OAKHEN1412/reaction-wheel-balance/HANDOFF.md

# Handoff — Reaction Wheel Balance

## 2026-09-19 ? Voltage/torque controller implemented

This supersedes the older speed-command diagnosis below: light-wheel steps
156/291/425 rpm at duty .29/.49/.68, t63 .155/.175/.215 s; adding rim nuts
increases tau to .45?.59 s with almost unchanged final rpm. Driver is voltage
mode, not a soft-start speed servo. Sim and firmware now default to signed
back-EMF compensation `(omega_est + .18*a)/omega_fs`; old mode stays selectable.
Measured electrical/IMU/FG constants preserved. DIR uses one zero-duty interval
then reverses even while spinning; estimator follows applied duty. CSV unchanged
but cmd_rpm now represents voltage-equivalent speed. No upload or COM3 access.

Keep Kp=1137.4, Kd=144.3, Kw=1, Ki=.0387; CONTROL_MODE_VOLTAGE=true,
MOTOR_TAU_S=.18 (light wheel), ACTIVE_DECEL_BRAKE=false. Saved EEPROM gains
still override config defaults. Six-case nominal recovery: 20/20 except
(.25 s, coast=.3) = 18/20; fixed-gain wheel-inertia sweep worst = 17/20,
one saturated run. Soft gains/higher Kd did not help.
Validation: 15/15 Python tests pass; Mega compile passes (24078 B flash,
1613 B SRAM). Extended firmware self-test compiled, not executed on board. See sim/README.md and
sim/voltage_results.json for protocol, limits and complete results. Need wheel
mass/inertia, low-duty behavior, FG sign accuracy and reverse/braking torque
measurements before treating these model results as hardware validation.

อัปเดตล่าสุด: 2026-09-19 · repo: `OAKHEN1412/reaction-wheel-balance`

## เป้าหมายโปรเจค
โครงตัว U ทรงตัวบนขอบฐานด้วยล้อเหวี่ยง 20 cm (reaction wheel) บนแกน X — **Arduino Mega 2560** อ่าน MPU-6050 แล้วสั่ง BLDC-3640 ขอบเขตในโครงงาน: เอียงไม่เกิน 5° บนพื้นราบ
ภาพรวม สเปก และงบประมาณอยู่ใน `project-brief.md` (สรุปจากสไลด์ PDF และ xlsx ของผู้ใช้ — สไลด์เดิมระบุ ESP32-C3 แต่โปรเจคเปลี่ยนเป็น Mega ถาวรแล้ว ดูหมายเหตุในไฟล์นั้น) และ `README.md`

## ทำเสร็จแล้ว (อ่านรายละเอียดจากไฟล์ ไม่ต้องทำซ้ำ)
| ส่วน | ไฟล์ | สถานะ |
|---|---|---|
| วงจร | `hardware/wiring.md`, `hardware/schematic.svg/.png` | รีวิวแล้ว ขาตรงตามสเปก |
| เฟิร์มแวร์ | `firmware/reaction_wheel_balance/`, `firmware/imu_test/`, `firmware/motor_test/`, `firmware/README.md` | compile ผ่านทุก sketch (รวม `sign_test`) · รีวิวและแก้ไปแล้ว 1 รอบ (8 จุด) |
| Simulation | `sim/` (`design_gains.py --set … --quick`, `hardware_requirements.py`, `README.md`) | unittest ผ่าน 8/8 |
| หน้าเว็บภาพรวม | `project-overview.html` + `assets/` (เผยแพร่เป็น artifact ส่วนตัว — ลิงก์อยู่กับเจ้าของโปรเจค) | v2 มีรูปโมดูลจริงและภาพ CAD แล้ว |

คำสั่ง compile: `arduino-cli compile --fqbn arduino:avr:mega firmware/<sketch>` (avr core ติดตั้งอยู่แล้ว) · upload ที่ `COM3` · Python ใช้ `py -X utf8`

## ข้อสรุปสำคัญ (ไม่ชัดเจนถ้าอ่านจากโค้ดอย่างเดียว)
- **กฎควบคุม:** ใช้ state feedback แล้วคำนวณเป็นความเร่งล้อ `a = Kp·θ + Kd·θ̇ + Kw·ω + Ki·∫θ` จากนั้นสะสมเป็น ω_cmd **ห้ามแปลงมุมเป็น PWM ตรง ๆ** เพราะแรงบิดปฏิกิริยาเป็นสัดส่วนกับความเร่งของล้อ
- **เกนทุกตัวเครื่องหมายบวกเหมือนกัน** ตาม LQR · Kp มีค่าต่ำสุดประมาณ m·g·l / I_w จึงห้ามจูนแบบเริ่มจาก Kp = 0 · เกนตั้งต้นใน `config.h` คือ Kp 1137, Kd 144.3, Kw 1.0, Ki 0.0387 ตรวจซ้ำที่อัตราทดจริง 6 แล้ว ได้ค่าเท่าเดิม (tau_m 0.06 s ยังเป็นค่าประมาณ)
- **Simulation:** ถ้าออกแบบเกนให้ตรงกับพารามิเตอร์แต่ละชุด จะฟื้นจาก 5° ได้ 19/20 รอบ แต่ต้องมีอัตราทด ≥ 3, แรงบิดล้อ ≥ 1.5 เท่าของแรงโน้มถ่วง และ tau_m ≤ 0.08 s · ฟื้นจาก 10° ไม่ได้ · **โหมดลุกเองจากท่านอน (jump-up) ทำไม่ได้** กับมอเตอร์นี้ (`ENABLE_JUMP_UP=false`)
- ยอด Monte Carlo ต่ำ ๆ ที่ worker รายงานรอบแรกเกิดจากใช้เกนชุดเดียวกับพารามิเตอร์ทุกช่วง แก้วิธีวัดแล้ว ดู `sim/README.md` §3.5–3.7
- รูป ESP32 และแบตในสไลด์เดิมไม่ตรงรุ่นที่ใช้จริง · รูปใน `assets/modules/` มาจากลิงก์ร้านใน xlsx

## ทดสอบฮาร์ดแวร์จริง 2026-09-19
- **MPU-6050 (GY-521) ตัวที่มีเสีย:** ตอบ WHO_AM_I=0x68, ACK ทุก byte (ยืนยันด้วย bit-bang I2C) แต่เขียน register ไม่ติด ค้าง sleep (PWR_MGMT_1=0x40) ค่า accel/gyro เป็น 0 — ต้องซื้อใหม่ · มี `tools/imu_viewer.html` (Codex สร้าง, Web Serial + 3D + Auto-suggest แกน/เครื่องหมาย) รอใช้กับตัวใหม่
- **มอเตอร์ BLDC-3640 วัดครบแล้ว** (ใส่ใน `config.h` + `wiring.md` แล้ว): สีสายจริง แดง +12V / ดำ GND / น้ำเงิน PWM **กลับขั้ว** (เริ่มหมุน ~10%) / เหลือง FG (~70 พัลส์ต่อรอบล้อ, ส่งเฉพาะตอนไดร์เวอร์ขับ) / ขาว DIR (LOW = CW) / เขียว BRAKE (LOW = เบรก, ผลน้อยกว่า duty 0 นิดเดียว)
- **เปลี่ยนคอนโทรลเลอร์เป็น Arduino Mega 2560 ถาวรแล้ว** — ขาว (DIR) และเขียว (BRAKE) มี pull-up ในไดร์เวอร์แรง (~1kΩ ไป 5V) ESP32 (3.3V) ผ่าน R ดึงลงไม่ได้ ต้องใช้ NPN ช่วย ส่วน Mega เป็น 5V logic ต่อตรงได้เลย **ไม่ต้องใช้ NPN อีกต่อไป** เฟิร์มแวร์พอร์ตเสร็จแล้ว เวอร์ชัน ESP32 เดิมย้ายไปเก็บที่ `firmware/legacy_esp32/`
- **ความปลอดภัย:** PWM กลับขั้ว → ถ้าขา PWM ลอย/LOW มอเตอร์วิ่งเต็มสปีด · **ปิดไฟ 12V ทุกครั้งก่อนแฟลช/รีเซ็ตบอร์ด** (Mega ก็ยังมีความเสี่ยงนี้ตอน reset/upload เหมือนกัน) · แนะนำใส่ pull-up 10k จาก D11 ไป 5V เป็น hardware safety net เพิ่มเติม
- `motor_test.ino` (Mega) รองรับคำสั่ง `duty`, `dir`, `brake`, `stop`, `count`, `resetcount`, `status`, `help`

## ยังค้าง / ขั้นต่อไป
0. **อัตราทดวัดแล้ว = 6** (2026-09-19 นับด้วยมือ: ล้อ 1 รอบ = มอเตอร์ 6 รอบ) ใส่ใน `config.h` และ `sim/params.py` แล้ว · รัน sim ใหม่ได้เกนเท่าเดิม ฟื้นจาก 5° ได้ 19/20 รอบ ไม่อิ่มตัว ล้อหมุนสูงสุด 157 จากขีดจำกัด 667 rpm แรงบิดล้อ 0.46 N·m เท่ากับ ~4 เท่าของแรงโน้มถ่วงที่ 5° · FG น่าจะเป็น 12 พัลส์ต่อรอบมอเตอร์ (72 ต่อรอบล้อ) ไม่ใช่ 70 ถ้าจะให้แม่นให้นับซ้ำ
1. **MPU-6050 ตัวใหม่ใช้งานได้แล้ว (2026-09-19)**: WHO_AM_I=0x68 ตอนวางนิ่ง az≈1.05g และ gyro bias ≈ (-1.1, 0.5, 1.7) dps · **ยืนยันแกนแล้ว:** accel ใช้ atan2(ay,az), gyro ใช้ X และเครื่องหมาย +1 ทั้งคู่ (Δθ +9.4°, corr 0.74) ใส่ใน `config.h` แล้ว ถ้าย้ายตำแหน่ง IMU ต้องวัดใหม่
1b. **ทิศควบคุมยืนยันแล้ว** (2026-09-19 ด้วย `firmware/sign_test/`): ล้อเร่งไป +ω แล้วโครงเอียงไป θ ลบ -10.3° · ล้อเร่งไป -ω แล้วโครงเอียงไป θ บวก +7.0° → `DEFAULT_CONTROL_SIGN = +1` ถูกต้อง · ทิศทางจริง: **เอียงซ้าย = θ ลบ** · IMU ตอนตั้งตรงอ่านได้ประมาณ -2 ถึง -3° ใช้คำสั่ง `zero` ในเฟิร์มแวร์หลัก
1c. **ทดสอบทรงตัวครั้งแรก (2026-09-19) ไม่สำเร็จ:** zero offset = -0.28° (บันทึกลง EEPROM แล้ว) · ทิศที่ controller ดันกลับถูกต้อง แต่โครงแกว่งแรงขึ้นทุกรอบ (+2.8 → -7.8 → +10.8 → -16.9°, คาบ ~0.85 s) แล้วล้มใน ~1.5 s เพราะล้อหมุนตามคำสั่งได้แค่ประมาณ 1/5 · `firmware/step_test/` วัดซ้ำ 2 รอบได้ผลเหมือนกัน: t63 = **0.45–0.59 s** (sim สมมติไว้ 0.06 s), ที่ duty เต็มล้อหมุนได้ประมาณ 585 rpm, ความเร่งสูงสุดของล้อประมาณ 50 rad/s² ≈ แรงบิด 0.125 N·m (ถ้า I_w = 0.00245) ซึ่งแค่พอสู้แรงโน้มถ่วงที่ 5° (0.108 N·m) sim เคยสมมติไว้ 0.46 · sim ที่ tau_m 0.15–0.45 ได้ 0/20 · ขั้วเวลาไม่เสถียรของโครงประมาณ 0.13 s เร็วกว่ามอเตอร์ประมาณ 4 เท่า → **ปัญหาอยู่ที่ฮาร์ดแวร์ ไม่ใช่การจูน** ดูทางเลือกในข้อ 2 · FG ส่งพัลส์เฉพาะตอนขับ จึงวัด coast ไม่ได้
2. **ขั้นต่อไป: เลือกทางแก้ actuator** (ก) หาว่าไดรเวอร์มี soft-start/accel ramp ไหม (ข) เพิ่มอัตราทดเป็นประมาณ 10–12 เพราะความเร็วล้อยังเหลือเยอะ (ค) ลดแรงโน้มถ่วง m·l: ย้ายแบตหรือ Mega ลงต่ำ (ง) ถ้ามอเตอร์รับได้ ลองใช้ไฟ 24V · เดิม: **ทดสอบทรงตัวครบระบบครั้งแรก** แกน IMU, อัตราทด, `MOTOR_MIN_DUTY_FRACTION` และทิศควบคุมวัดครบแล้ว · แฟลช `reaction_wheel_balance` ตอนปิด 12V → ตั้งตรงแล้วใช้คำสั่ง `zero` → `start` โดยมีมือกันล้มไว้
3. หลังวัดมวล COM I_w และ tau_m จริง (รวมมวล/COM ที่เปลี่ยนไปจาก Mega ที่หนักกว่า ESP32-C3 Super Mini มาก — ~37g เทียบ ~2g, ขนาด ~101.5×53.3mm เทียบ ~22×18mm ต้องคิดในตำแหน่งจริงบนโครง) → รัน `sim/design_gains.py --set … --quick` → อัปเดตเกน
4. สไลด์ยังว่างสองหน้า: "ทบทวนงานวิจัยที่เกี่ยวข้อง" และ "สรุปและข้อเสนอแนะ" · ตัวเลขงบในสองชีตของ xlsx ไม่ตรงกัน

## ข้อตกลงการทำงานกับผู้ใช้
- สื่อสารภาษาไทย · ผู้ใช้สั่งงานแบบหัวหน้าคุมลูกน้อง ผ่าน skill `/engineer`: Opus วางแผนและรีวิว ส่วน `worker-general` (Sonnet) ลงมือทำ
- งานยาวให้แจ้งผ่าน PushNotification เมื่อเสร็จ
- ถ้าแก้หน้าเว็บให้ republish ที่ URL เดิม (ใช้ `url` ถ้าอยู่ต่าง session) อย่าสร้าง artifact ใหม่

## Suggested skills
- `engineer` — เมื่อต้องแตกงานให้ worker ทำ (แก้วงจรเพิ่มไดโอด, bring-up tooling)
- `artifact-design` — ก่อนแก้ `project-overview.html` แล้ว republish
- `diagnose` / `debug-mantra` — ตอนทดสอบกับเครื่องจริงแล้วเจอบั๊ก (บูตไม่ขึ้น, ทรงตัวไม่ได้, IMU อ่านไม่ได้)
- `tdd` — ถ้าเพิ่ม logic ใหม่ใน header pure-logic ของเฟิร์มแวร์ หรือใน `sim/`
- `tailsync` — ถ้าต้องย้ายไฟล์ใหญ่ เช่นไฟล์ CAD หรือ log telemetry ไปเครื่อง hub

## ทดสอบทรงตัวรอบ 2 (voltage mode, 2026-09-19)
- ทรงตัวได้ประมาณ 1–7 วินาทีต่อครั้ง (20 ครั้ง) ดีกว่ารอบแรก แต่ยังล้มทุกครั้ง · log: scratchpad `balance_attempt2.log`
- **สาเหตุหลัก: FG มีพัลส์หลอก** (ห่างกันประมาณ 25–35 µs ช่วงที่กลับทิศ) ทำให้อ่านความเร็วล้อได้ 30,000–42,000 rpm → ในโหมด voltage ทำให้ duty ชน 100% ไปทิศผิดนานประมาณ 300 ms (เกิด 588 จาก 7204 sample)
  - แก้แล้วใน `fg_tach.cpp`: ทิ้งพัลส์ที่ห่างกันน้อยกว่า `FG_MIN_PERIOD_US` (700 µs) และให้ค่าความเร็วลดลงเองเมื่อไม่มีพัลส์ใหม่ · ~~ใส่ pull-up 4.7k~~ **ห้ามใส่** (ดูหัวข้อ 2026-09-20: ใส่แล้ว FG แย่ลง)
- ปัญหารอง: 20–40% ของเวลา duty อยู่ใต้ 0.10 ซึ่งเป็นช่วงที่มอเตอร์ไม่ออกแรง ถ้าแก้ FG แล้วยังส่ายไปมาช้า ๆ ให้เพิ่มการชดเชย deadzone ในโหมด voltage

## 🎉 ทรงตัวได้สำเร็จครั้งแรก (2026-09-19, รอบ 3 + จูน Kd)
- ใช้โหมด voltage + ตัวกรอง FG · Kd 144.3 (ค่าจาก LQR) → ทรงได้ 1.5–8 วินาที · Kd 220 → ดีขึ้นมาก · **Kd 300 → ทรงได้ต่อเนื่องมากกว่า 2 นาทีโดยไม่ล้ม**
- 10 วินาทีสุดท้าย: θ เฉลี่ย -0.33°, SD 1.7°, อยู่ในช่วง -3.7 ถึง +3.1° · ส่ายด้วยคาบ ~0.47 s · ล้อหมุนเฉลี่ย +137 rpm (ช่วง 40–223) · duty สูงสุด 0.47 · ไม่พบค่าหลอกจาก FG
- บันทึก Kd 300 ลง EEPROM แล้ว และตั้งเป็น `DEFAULT_KD` ใน `config.h` แล้ว (Kp 1137.4, Kw 1.0, Ki 0.0387 เท่าเดิม)
- ขั้นต่อไป: ลดการส่าย (ลอง Kd 350–400 หรือปรับ Kp), ล้อค้างอยู่ฝั่งบวกประมาณ 137 rpm (ลองเพิ่ม Kw เพื่อดึงความเร็วล้อกลับศูนย์), ทดสอบรับแรงผลัก

### จูนลดการส่าย (Kd, เปลี่ยนค่าระหว่างที่ทรงตัวอยู่)
| Kd | SD ของ θ | ช่วงของ θ | คาบการส่าย |
|---|---|---|---|
| 300 | 1.59° | -4.3 ถึง +3.7° | 0.46 s |
| 350 | 0.71° | -2.4 ถึง +1.9° | 0.35 s |
| 400 | 0.49° | -2.5 ถึง +2.1° | 0.28 s |
| **500** | **0.34°** | **-1.4 ถึง +0.8°** | 0.20 s |
- **ใช้ Kd 500** บันทึกลง EEPROM และตั้งเป็น `DEFAULT_KD` แล้ว · duty กระตุกเพิ่มขึ้นประมาณ 20% แต่ยังไม่มีอาการสั่นหรือเสียงหึ่ง · ถ้าเพิ่ม Kd ต่อ ได้ประโยชน์น้อยลงเรื่อย ๆ และเสี่ยงสัญญาณรบกวน
- ความเร็วล้อค้างเฉลี่ยประมาณ -91 rpm (ไม่กลับศูนย์) → ถ้าจะแก้ ลองเพิ่ม Kw

## Jump-up (ลุกขึ้นเองจาก ±16°) + หน้าเว็บควบคุม (2026-09-19, Codex)
- **sim** (`sim/jumpup.py`, ผลทั้งหมดอยู่ที่ `sim/out/jumpup/` + README): ใช้โมเดล voltage-mode + reverse-plugging รัน 2,970 กรณี → ทำได้ในทางทฤษฎีที่ความเฉื่อยล้อ ≥0.75× ของค่าประมาณ แม้ในกรณีแย่ (plug ได้แรงครึ่งเดียว + dead time 20–50 ms) · ที่ 0.5× ต้อง ≥250 rpm และถ้า pessimistic จะไม่สำเร็จเลย · ยังไม่ได้ทดสอบกับเครื่องจริง
- **เฟิร์มแวร์:** `jump_controller.h` + คำสั่ง `jump [rpm] [kick_ms]` / `jumpcfg` · ต้องสั่งเองเท่านั้น, โครงต้องวางพักนิ่ง 10–22° นาน 500 ms, ต้องเห็นพัลส์ FG จริง, จำกัดความเร็วล้อ ≤550 rpm, kick ≤500 ms, ยกเลิกเมื่อเอียงเกิน 25° หรือเกิน 2 s · ค่าเริ่มต้นแบบปลอดภัย `jump 100 20` (ยกขึ้นแค่ประมาณ 1°) · ค่าที่คาดว่าจะใช้ได้ `jump 200 350`
- **หน้าเว็บ** `tools/imu_viewer.html` แท็บ Balance control: ปุ่ม Start/Stop(Esc)/Jump/Zero, แก้เกน, กราฟ real-time, สถิติ, บันทึก CSV, serial console
- ขั้นต่อไป: แฟลช (ปิด 12V) → ทดสอบ jump แบบค่อย ๆ เพิ่ม: 100/20 → 100/100 → 150/200 → 200/350 โดยมีมือกันอีกฝั่งไว้

## 🎉 ลุกขึ้นเองสำเร็จ (2026-09-20)
- **`jump 500 350` ลุกจาก -15.6° ขึ้นมาตั้งตรง แล้วทรงตัวต่อได้เอง** (ยังทรงตัวอยู่หลังจากนั้นอีกกว่า 10 วินาที) · log: scratchpad `jump_success.log`
  - หมุนล้อที่ duty 1.0 จนถึง 480 rpm (ใช้ประมาณ 380 ms) → กลับทิศเต็มกำลัง → โครงยกขึ้นเร็วสุด 76 °/s → ส่งต่อเข้าโหมดทรงตัวที่ -9.5° ภายใน ~190 ms → เลยไปอีกฝั่งสูงสุด +4.4° → กลับมานิ่งที่ประมาณ 0°
- เส้นทางการทดสอบ: 100/20 ยกขึ้น 1.7° · 100/100 ~-3.5° แต่เบรกตอน abort ดึงกลับ · 100/200 และ 200/350 ส่งต่อได้ที่ -9.5° แต่ตอนนั้นโครงกำลังตกกลับ · 350/350 ขึ้นถึง -3° แต่ความเร็วล้อไม่พอ · **500/350 สำเร็จ**
- sim ประเมินเกินจริง (คาดว่า 200 rpm พอ) → โครงจริงน่าจะมีความเฉื่อยหรือ m·l มากกว่าค่าใน `params.py` หรือ I_w น้อยกว่า · ถ้าจะให้ sim แม่นต้องวัด I_w, มวล และ COM จริง
- แก้เฟิร์มแวร์ระหว่างทดสอบ (โค้ดของ Codex + ที่ supervisor แก้): พิมพ์เหตุผลที่ abort · ผ่อนตัวป้องกันตอนหมุนล้อ (4°/40 dps เพราะขอบกั้นยุบตัวได้) · duty ตอนหมุนล้อปรับตามความเร็วที่ขอ (rpm/450, ต่ำสุด 0.6) · เช็ค FG เกินความเร็วเฉพาะตอนหมุนล้อ (ตอนกลับทิศ FG มีพัลส์หลอก 782 rpm) · **ข้าม accelerometer เมื่อ |a| ต่างจาก 1g เกิน 0.25g** (แรงกระแทกทำให้มุมเพี้ยนประมาณ 10°)
- ค่าเริ่มต้นใน `config.h` ตอนนี้คือ `JUMP_SPIN_RPM 500`, `JUMP_KICK_MS 350` → พิมพ์ `jump` ได้เลย หรือกดปุ่ม Jump บนเว็บ

## 🎉 Jump-up สำเร็จ — ค่าท่ีทำงานได้ (2026-09-20, ~00:44)
- **`jump 550 450 8`** = ค่ากลางท่ีทำงานได้: ลุกจาก -15.5° ขึ้นมาตั้งตรง แล้วทรงตัวต่อเองใน ~1.4 s (log: scratchpad `jump_success2.log` line 3146+, 0 FALLEN)
  - เปรียบเทียบ: `500/350/10` = ไม่ถึง (ค้าง -4.5°, เร็วสุด 50°/s) · `550/450/6` = แรงเกิน (พุ่ง 200°/s, ส่งต่อที่ -5.3° เร็วเกิน, ล้ม +15.9°)
- ⚠️ **ยังต้องทดสอบซ้ำ 2-3 ครั้งเพื่อความชัวร์** ก่อนตั้งเป็นค่าเริ่มต้นถาวร
- ⚠️ `config.h` ตอนนี้เป็น `JUMP_SPIN_RPM 500 / JUMP_KICK_MS 350` (ค่าเก่า) → **ต้องอัปเดตเป็น 550/450/8** หลังยืนยันความซ้ำได้ (command reject >550 rpm)
- ⚠️ ตอนจบ session เดิม **COM3 หาย** (GetPortNames ว่าง) + serial bridge ตาย → agent ใหม่ต้องกู้ COM3 + รัน `bridge.ps1` ใหม่ก่อน (ปิด 12V ก่อน)
- ค่า control ปัจจุบัน: Kp 1137.4, **Kd 500** (SD 0.27°), Kw 1.0, Ki 0.0387 · wheel-speed bias ค้าง ~-80 ถึง -110 rpm (แก้: เพิ่ม Kw)
- Handoff ฉบับเต็มของ session นั้นอยู่ใน scratchpad ของเครื่อง (ไม่ได้ commit)

## ปรับ jump + FG (2026-09-20, ต่อ)
- **ห้ามใส่ R pull-up ภายนอกที่ FG:** ทดสอบแบบ A/B ด้วย `motor_test` → ใส่ 4.7k ไป 5V นับพัลส์ได้แค่ ~60/100/70 ต่อวินาทีที่ duty 300/600/900 · **ถอดออกได้ 187/421/645** (ถูกต้อง) · ใช้ INPUT_PULLUP ของ Mega อย่างเดียว
- ทิศมอเตอร์ตรวจซ้ำแล้ว: `dir 1` = ทวนเข็ม, `dir 0` = ตามเข็ม (ตรงกับค่าเดิม)
- แก้เฟิร์มแวร์เพิ่ม: ถ้า FG ไม่มาเกิน max(4×คาบ, 15 ms) ให้ถือว่าไม่ fresh · **WheelSpeedEstimator ใช้โมเดลเป็นหลักแล้วปรับตาม FG** (τ แก้ 30 ms, ทิ้งค่าที่ต่างเกิน max(15 rad/s, 35%) ยกเว้นต่างต่อเนื่องเกิน 0.1 s) · ถ้า FG หลุดระหว่างหมุนล้อ jump จะกลับทิศตามโมเดลแทน · **FALL_HOLD**: ถ้า |θ|>12° ต่อเนื่อง 300 ms → FALLEN (เดิมพิงขอบกั้นที่ 16–18° แล้วมอเตอร์เต็มกำลังค้าง 8 s)
- ทรงตัวกับ estimator ใหม่: SD 0.27° (เดิม 0.34°), มุมเฉลี่ย -0.01°
- **jump 500/350: ลุกถึง ~0° ได้แทบทุกครั้ง แต่ทรงตัวต่อสำเร็จแค่ 1/6** · หลังส่งต่อ โครงค้างที่ ~-4° เพราะล้อเร่งได้จริงแค่ ~40 rad/s² ขณะที่โมเดลคาด ~110 → ล้อชนเพดาน -500 rpm แล้วล้ม · สงสัยว่า**กระแสถูกจำกัด** (τ เพิ่มตาม duty ด้วย: 0.16→0.22 s) · **ขั้นต่อไป: เช็คว่าแหล่งจ่าย 12V จ่ายได้กี่ A** (ถ้า <3A ลองเปลี่ยนเป็น ≥5A) · ทางอื่น: หมุนล้อที่ 550 rpm, ลดมุมส่งต่อ, หรือจัดการโมเมนตัมล้อหลังส่งต่อ
- log ทั้งหมดเก็บใน scratchpad ของ session (`jump_session*.log`, `jump_success.log`, `fg_diag.log`)

## อัปเดต 2026-09-20 (ต่อ) — คำสั่ง jump 3 พารามิเตอร์ + แหล่งไฟ
- **คำสั่ง `jump` รับ 3 พารามิเตอร์แล้ว** (ไม่ต้องแฟลชระหว่างเทส): `jump [rpm] [kick_ms] [capture_deg]` (capture 3-15°) · `jumpcfg` พิมพ์ค่า · compile ผ่าน, selftest ผ่าน 3 ข้อ
- **แหล่งจ่ายไฟ 12V เปลี่ยน/ปรับไม่ได้เลย** (ผู้ใช้บอก) → แก้ที่ซอฟต์แวร์: หมุนล้อก่อนกลับทิศที่ 550 rpm (โมเมนตัมมากขึ้น) + ปรับมุมส่งต่อ (capture_deg)

## ลุกขึ้นเองแบบคงที่ (2026-09-21)
- **กติกาส่งต่อใหม่: คุมความเร็วแทนมุม** — ตัวชี้วัดที่ตัดสินผลคืออัตราเอียงตอนส่งต่อ (ดู `tuning/jump_runs.csv`)
  เตะจนอัตราเอียง > 90 °/s → **COAST** (ปล่อยไหล) → ส่งต่อเมื่อ |θ| ≤ 8° และอัตราเอียงอยู่ใน 60–90 °/s · ถ้าไหลช้ากว่า 60 °/s กลับไปเตะต่อ
- `jump 550 450 8 75` **สำเร็จ 3/3** (นิ่งใน 1.0–2.6 s, เลยไปอีกฝั่ง 5.7–7.4°) เทียบกับแบบมุมคงที่ที่ได้ 3/10 · ตั้งเป็นค่าเริ่มต้นใน `config.h` แล้ว
- ลองสูตรพลังงาน `v ≥ √(2K(1−cosθ))` แล้ว **ใช้ไม่ได้** (K=70 ทั้งแบบไม่จำกัดมุมและจำกัด ≤10° ยังเลยไปล้ม) เพราะหลังส่งต่อโหมดทรงตัวออกแรงเพิ่มด้วย
- คำสั่ง: `jump [rpm] [kick_ms] [capture_deg] [rate_dps]` · `jumpcfg` แสดงค่าปัจจุบัน
- **ข้อมูลการจูนทั้งหมดย้ายไปอยู่ใน `tuning/`** (`jump_runs.csv`, `balance_gains.md`, `motor_fg.md`, `logs/*.log.gz`, `tools/`)

## Session 2026-09-22 → 23 (Opus/Fable) — ฐานลื่นคือตัวแปรหลัก, ลิงก์ serial คือตัวขวาง

**อ่านก่อนทำต่อ:** `tuning/README.md` หัวข้อ 2026-09-22/23 · ข้อมูลสะอาดชุดเดียวคือ `tuning/nano_2026-09-22_left_after_base_fix.csv` (33 ครั้ง, 7 สำเร็จ)

### สิ่งที่พิสูจน์แล้ว (เชื่อได้)
- **ฐานลื่น = ตัวแปรที่ทำให้ 90 ครั้งก่อนหน้าจูนไม่ขึ้น** ก่อนแก้: ความเร็วส่งต่อ SD 21.5 dps, corr(เวลา, ความเร็วส่งต่อ) = −0.79, มุมนอนไหล +0.56 ตามเวลา · หลังใส่ยาง/ตัวกั้น: SD 9.6, corr −0.28, มุมนอนนิ่ง (+0.06) · **ต่อจากนี้เทียบ A/B ต้องสลับ A,B,A,B เท่านั้น** (`autofire.py --params-b`)
- **หน้าต่างส่งต่อ 53–61 dps**: 7 ครั้งที่สำเร็จอยู่ในนี้ทั้งหมด · >78 dps เลยไปอีกฝั่ง 16–19° (0/9) · <46 dps ขึ้นไม่ถึง duty ตัน 27–56% (0/12) · ในหน้าต่าง ล้อ ≥130 rpm → 7/8 · **ยังไม่ได้ทดสอบกับข้อมูลใหม่ ห้ามใส่ config จนกว่าจะยืนยัน**
- ตัวคั่นผลที่ทำนายได้จริงตัวเดียว: duty ตันใน 1 วิแรกหลังส่งต่อ (สำเร็จ 0–12%, ล้ม 14–56%) — `jumpruns.py` คำนวณให้
- **spin-up คงที่ทั้งวัน** (rpm@300ms 440–449 ทุก session, `tuning/tools/spinup.py`) → ไฟ 12V ไม่ตก ตัดเรื่องแบตทิ้งได้
- COAST สั้นแค่ 0–80 ms ในทุกครั้ง → `JUMP_COAST_HOLD_DUTY` (0.20 ใน config, arg ที่ 5 ของ `jump`) **น่าจะมีผลน้อยกว่าที่ออกแบบไว้** ยังไม่มีข้อมูลสะอาดตัดสิน (ชุด A/B ทั้งสองถูกลิงก์เพี้ยนปน ทิ้งหมด)
- **sim 2 ตัว (Codex `sim/capture_set.py`, Fable `sim/nano_replica.py`) ไม่ผ่านด่านทำนาย 25 ครั้งที่รู้ผล** ตัวแรกทายล้มหมด ตัวหลังทายรอดหมด — ห้ามใช้แผนที่ของทั้งคู่ · ของมีค่าจาก Fable: มอเตอร์เร่งจากนิ่งได้ ~200 rad/s² (ไม่ใช่ 40 — ตัวนั้นคือ back-EMF ที่ 350–450 rpm), friction offset 0.035 duty, accel lever-arm ทำมุมที่ log กระโดด +4° ตอนส่งต่อ, SD มุมจริง (gyro) 0.15° ไม่ใช่ 0.27

### ปัญหาที่ยังค้าง — ลิงก์ serial ผ่าน CH340 บนบอร์ด
- อาการ: **บอร์ดส่งออกได้ แต่รับคำสั่งไม่ได้** (`get` 0/10, avrdude "not in sync", DTR reset ไม่ถึงชิป) · เกิด 4 ครั้ง ทุกครั้งหลังยิงมอเตอร์หลายครั้งหรือหลังสับสวิตช์ 12V · หายเอง 2 ครั้ง (ไม่ใช่เพราะเสียบใหม่อย่างที่คิดตอนแรก) · ครั้งสุดท้ายไม่หาย: ลอง 3 พอร์ต 2 สาย ถอดสายไดรเวอร์ทั้ง 4 เส้นแล้ว
- **Blink 1 KB ก็อัปโหลดไม่ได้** (not in sync resp=0x00 เหมือนกัน) → ยืนยันว่าเป็นลิงก์ CH340→ATmega ไม่ใช่สเก็ตช์/ขนาดแฟลช
- แฟลชล้มเหลวกลางคันทำสเก็ตช์เสียได้ (เกิดแล้ว 1 ครั้ง กู้ด้วยแฟลชซ้ำ) · `pnputil /restart-device` แก้ได้ถ้ารันเทอร์มินัลแบบ **admin** (คราวนี้ Access denied)
- **ทางแก้ session หน้า (เลือกหนึ่ง):** USB-TTL แยก → D0/D1/RST(ผ่าน 100nF) · หรือ Mega เดิมรัน passthrough Serial↔Serial1 · หรือ Uno ที่ดึง RESET ลง GND เป็นสะพาน — ทั้งหมดข้าม CH340 บนบอร์ด · **ระยะยาว:** USB isolator หรือแยกกราวด์ USB จากกราวด์มอเตอร์
- เฟิร์มแวร์ที่**ยังไม่ได้ขึ้นบอร์ด** (compile ผ่าน, host test ผ่าน): ack ของ `jump` ทวนค่าที่รับ (`rpm= kick= cap= rate= hold=`) และ `autofire.py` ตรวจ echo · บนบอร์ดตอนนี้คือ commit `22510ee` (มี coast-hold แต่ไม่มี echo)

### กฎการทำงานที่ได้จากวันนี้
- **ทุกครั้งที่ RX ตาย ให้ทดสอบด้วยการแฟลช ไม่ใช่ `get`** — ถ้าสเก็ตช์เสียอยู่ `get` จะเงียบแม้ RX ดี
- **อย่าเชื่อผลใด ๆ ที่บอร์ดไม่ได้ตอบ `jump: SPINUP`** (`autofire.py` แก้ให้ปฏิเสธแล้ว 2 รอบ — บั๊กแรกเช็ก FALLEN ก่อน ack)
- ตั้งกฎจากข้อมูล ≥20 ครั้ง และต้องผ่านการทำนายล่วงหน้ากับชุดใหม่ (วันนี้คำทำนาย "rate 75 จะดี" ผิด 0/9 — จับได้เพราะประกาศก่อนยิง)
- Arduino Cloud Agent แย่งพอร์ตตอนแฟลช → ปิดก่อน · COM port เปลี่ยนทุกครั้งที่ย้ายพอร์ต (วันนี้ 9→7→9→8→7) ให้ detect ทุกครั้ง

## Session 2026-10-13 — แก้บั๊กตัวประมาณความเร็วล้อ, ทดสอบแรงผลัก (ตาราง 4.12)

**สถานะบนบอร์ด:** เฟิร์มแวร์ = commit นี้ (git c622783 + ตัวแก้ `wheel_speed_estimator.h`) 27,714 B, hex ตรงกับที่ build จาก repo · offset 4.068° อยู่ใน EEPROM · Kd 450 / Kw 3 / Ki 0.0387 · ผู้ใช้ลองแล้วบอกว่า "ตัวนี้ดีกว่า"

### สิ่งที่พบ (เชื่อได้)
- **บั๊กตัวประมาณความเร็วล้อ:** FG ไม่มีเครื่องหมาย เครื่องหมายมาจากโมเดล (tau 0.18) แต่ล้อจริงกลับทิศเร็วกว่า (replay log ได้ tau จริง 0.05–0.08 s) ตัวแก้ขนาดจาก FG จึงลากค่าประมาณให้โตไปทิศเดิม เช่น −210 rpm ขณะที่ล้อจริง +330 rpm แล้วโหมด voltage ก็หักแรงดันผิดทาง 12 ใน 14 ครั้งที่ล้มตอนทดสอบผลักมีลายเซ็นนี้ · **แก้แล้ว:** ขณะที่คำสั่งสวนกับค่าประมาณ ให้จำ FG ต่ำสุด ถ้า FG กลับขึ้นเกิน min×1.3+3 rad/s ให้ใช้เครื่องหมายตามคำสั่ง · เทส 4–5 ใน selftest (เทส 4 พังกับโค้ดเดิม) · **A/B สลับแบบ blind (1-0-0-1-1-0-0-1 ทุก 15 s): ผลัก 34 ครั้งล้ม 0 vs 26 ครั้งล้ม 5** (`tuning/tools/estfix_ab.py`, `tuning/logs/nano_2026-10-13_estfix_ab.log.gz`)
- **ตำแหน่ง IMU:** ผู้ใช้ลองย้าย IMU ไปจุดอื่น (ยึดน็อตแน่น) → gyro ชน ±500 dps (gyro_sat 203, jumps 774, imu_fail 0) ล้อสั่นกลับทิศเต็มแรง · ย้ายกลับจุดเดิม (แกน atan2(ay,az), gx, +1/+1 ตาม 09-19, sign_test ยืนยัน +1) หายสนิท · **อย่าย้าย IMU** ถ้าจำเป็นต้องย้ายให้รัน imu_test + sign_test และถ้า sign_test ต้องการ −1 ให้กลับเครื่องหมาย IMU ทั้งคู่ ไม่ใช่ DEFAULT_CONTROL_SIGN (sign คูณ Kw·ω ด้วย และ jump ต้องการ +1)
- **สาย FG (เหลือง, D2) หลวม 3–4 ครั้งในวันเดียว** อาการมี 3 แบบ: ไม่มีพัลส์ (ความเร็วล้อค้างที่ค่าโมเดล ±496 rpm, duty ค้าง 0.85) / พัลส์รบกวนท่วม (fg_rej หลักหมื่น, ล้ออ่าน −1100 rpm, duty ค้าง 1.0) / ปกติ → **ต้องบัดกรีหรือใช้คอนเนคเตอร์ล็อก** ก่อนเก็บข้อมูลจริงทุกครั้งเช็กว่า FG นับขึ้น (`motor_test` หมุน duty 150 ได้ ~60 พัลส์/วินาที)
- **เวลาลูปชิด 2 ms:** รอบควบคุมสูงสุด ~2.2 ms, พิมพ์ telemetry หนึ่งบรรทัด ~2.9 ms · ลองเพิ่มตัวนับ diag ใน `get` แล้วผู้ใช้รู้สึกว่าสั่นกว่า (loop_overruns 244,911 เทียบ 29,657 ของตัวที่ไม่มี diag) จึงไม่ commit ตัวนับ diag · ถ้าจะปรับต่อควรลดเวลาคำนวณต่อรอบก่อน
- **zero:** ทรงตัวนิ่งที่ θ ≈ −1.3° ล้อค้าง ~113 rpm · ลอง zero ระหว่างทรงตัวไปที่ 2.754° แล้วล้ม 3/3 → มุมเอียงนี้น่าจะเป็นสมดุลกับแรงเสียดทาน ไม่ใช่ zero ผิด · ใช้ 4.068° ที่ตั้งด้วยมือ
- **เริ่มคุมทันทีตอนถึงจุดสมดุล** (1.5°, <20°/s, ไม่รอ) ลองแล้วผู้ใช้ให้กลับไปใช้แบบเดิม (3° ค้าง 500 ms)

### ทดสอบแรงผลัก (รายงาน 4.5.2) — ข้อมูลจากโค้ด**ก่อน**แก้บั๊ก
- ตาราง 4.12 = รอบที่ 2 ของ `tuning/logs/nano_2026-10-13_push_test.log.gz` (t ≥ 752 s) 9 แถว: กลับมาได้ 6 (2.5–4.5°, 0.23–0.68 s), ล้ม 3 · รอบที่ 1 (23 ครั้ง) ใช้ยืนยันว่ารับได้ ~5° · วิเคราะห์ด้วย `tuning/tools/pushtest.py` · มุมวัดเทียบมุมเฉลี่ยตอนนิ่ง (−1.1°)
- ~~ผู้ใช้เลือกให้ 4.5.2 อธิบายการล้มด้วย duty/ความเร็วล้ออิ่มตัวเท่านั้น~~ → ภายหลังผู้ใช้สั่งให้แก้เล่มตามโค้ดล่าสุด ดูหัวข้อถัดไป

### กฎการทำงานจากวันนี้
- `arduino-cli upload` ไม่ verify (`-V`) และ upload แบบปกติเคย verify พังที่ 0x7800 → **compile `--output-dir X` แล้ว `upload --input-dir X --verify` เสมอ**
- เทสบนเครื่อง: `py -m ziglang c++ -std=c++11 firmware/tests/jump_selftest.cpp` (ziglang ติดตั้งผ่าน pip)
- บอร์ดบูตด้วย run=1: ถ้าโครงตั้งตรงตอน 12V ปิด จะเข้า BALANCING แล้ว duty สะสมขึ้น ~0.85 → ส่ง `stop` ก่อนเปิด 12V ถ้าต่อคอม / ใช้แบตอย่างเดียว: วางโครงนอน เปิดไฟ รอ 3 s แล้วค่อยยก
- เปิดพอร์ตบางครั้งรีเซ็ตบอร์ด → ถาม/ปิด 12V ก่อนเปิดพอร์ตทุกครั้ง
- ทำนายผลก่อนทดสอบทุกครั้ง (วันนี้คำทำนายเรื่อง Kd 300, ย้ายกราวด์, แก้ zero ผิดทั้งหมด ส่วนเรื่องตำแหน่ง IMU และตัวแก้บั๊กถูก)

## Session 2026-10-13 (ต่อ) — เล่มรายงาน: ผลตัวแก้บั๊ก, รูปถ่าย, QR, เรียบเรียงภาษาบท 3–5

**ที่อยู่ของเล่ม:** `report/` · commit เฉพาะ `report/_source` (สคริปต์สร้างเล่ม) และ `report/README.md` · ไฟล์ Word/PDF/รูป/ฉบับเก่า อยู่นอก git ตามที่ผู้ใช้เลือก (มีชื่อและข้อมูลส่วนตัว และ repo เป็นสาธารณะ) ดู `.gitignore` · วิธีสร้างใหม่อยู่ใน `report/README.md`

### ทำแล้ว
- บท 4–5 ใส่ผลตัวแก้บั๊กตัวประมาณ: 4.2.4, 4.5.2 + ตาราง 4.13 (A/B 0/34 vs 5/26), 4.6 ข้อ 3, 5.1.2, 5.1.4, ตาราง 5.1 · รูป 4.9 กราฟผลักครั้งที่ 3–6 (`figs.py`)
- รูปถ่ายต้นแบบ (iPhone → Taildrop → Downloads ของ laptop, ไม่อยู่ใน repo): รูป 4.1 = IMG_5799+IMG_5790, รูป 3.13 = IMG_5796+IMG_5794 ประกอบด้วย `photos.py <โฟลเดอร์รูป>`
- หัวข้อใหม่ 3.3.6 + รูป 3.15 หน้าจอโปรแกรมจำลอง (`sim_mockup.py <repo>/sim`) ตัวเลขจากการรัน `sim/` จริงด้วยค่าช่วงออกแบบ (tau_m 0.06, speed mode): 19/20 ครั้ง, LQR Kp 1137.4 / Kd 144.3
- ภาคผนวก ก: QR ไป `github.com/OAKHEN1412/reaction-wheel-balance` + commit 1758122 + ตารางโฟลเดอร์ (`build_appendix.py`, ต้องมี segno) — **ถ้าเปลี่ยนชื่อ/ย้าย repo QR ในเล่มจะเสีย**
- เรียบเรียงภาษาบท 3, 4, 5 ให้อ่านง่าย (ผู้ใช้ตอบ "ง่ายกว่านี้อีก" หลังเห็นตัวอย่างแรก): ประโยคสั้น อธิบายศัพท์ตอนใช้ครั้งแรก แยกผลเป็นข้อ ๆ ตัวเลข/ตาราง/สมการไม่เปลี่ยน · แก้ข้อผิดในบท 3: เฟิร์มแวร์ไม่ได้ใช้ DMP (อ่านค่าดิบ + complementary filter เอง) และตัวควบคุมไม่ใช่ PID อย่างเดียว (มี Kw) · ต้นบท 4 มีส่วน "คำศัพท์และสัญลักษณ์ที่ใช้ในบทนี้" (duty, PWM, FG, Kp/Kd/Ki/Kw, SD ฯลฯ) ไม่มีเลขหัวข้อ เลขตาราง/รูปจึงไม่เลื่อน
- บท 3 สร้างจาก `build3.py` ไม่ได้ (ไม่มี `ch3img/`) → แก้ docx ตรง ข้อความปัจจุบันอยู่ใน `ch3_rewrite.py` (สคริปต์รันครั้งเดียวบนผลของ build3.py) · บท 4/5/ภาคผนวกสร้างจาก build4/5/appendix
- `docxlib.thai_breaks` ไม่ตัดบรรทัดชิดวงเล็บ/เครื่องหมายคำพูดแล้ว · ตาราง 5.1 ตั้ง cantSplit (แถวเคยขาดข้ามหน้า)
- หน้าปัจจุบัน: บท 3 = 17, บท 4 = 21, บท 5 = 4, ภาคผนวก = 2 · ฉบับก่อนแก้ทุกครั้งอยู่ใน `report/_ต้นฉบับเก่า/`
- ส่ง Word+PDF ทั้งหมดให้เพื่อนทาง Messenger แล้ว (แชท E2EE ไม่รับ .zip, ตัวอัปโหลดของ Chrome จำกัด 10 MB/ครั้ง → `หน้าปกเล่ม.doc` 10.7 MB ไม่ได้ส่ง ผู้ใช้บอกไม่ต้อง เป็นเล่มเก่า 131 หน้า) · ส่งบท 5 ฉบับใหม่ตามไปอีกรอบ
- วิดีโอจาก iPhone 10 คลิป (IMG_5801–5820, IMG_5806 มาซ้ำ) อยู่ใน Downloads ยังไม่ได้ใช้ในเล่ม (ผู้ใช้บอกจะส่ง 13)

### ยังค้าง
- **บทคัดย่อ (`หน้าปก.docx` ทั้งไทยและอังกฤษ) ยังเขียน ESP32-C3 และ "PID"** และช่วงมุม "±5 องศา" หายไปเหลือช่องว่าง → ต้องแก้เป็น Arduino Nano / PID + Kw และใส่ผลหลัก (515.7 s, ±2.2°, ผลัก 0/34 ล้ม)
- ตาราง 5.1 แถว "ส่งคำสั่งไปบอร์ดไม่ได้": วิธีแก้เขียนว่า "แยกกราวด์ของวงจรสื่อสาร" แต่ตอนนี้ Nano ต่อกราวด์จุดเดียวกับมอเตอร์ → ให้ผู้ใช้ยืนยัน หรือย้ายไปเป็นข้อเสนอแนะ
- ตาราง 4.10 มุมศูนย์ +0.399° เป็นค่าช่วงจูน (IMU/สายชุดเดิม) ถูกต้องตาม log แต่ไม่ใช่ค่าบนบอร์ดตอนนี้ (4.068°)
- ฮาร์ดแวร์: สาย FG ต้องบัดกรี/ล็อก · ยังไม่มี guard เมื่อ FG หาย/ผิดปกติ · เวลาลูปชิด 2 ms
