OAKHEN1412/reaction-wheel-balance/project-brief.md

# Reaction Wheel Balance — สรุปโปรเจค

> สรุปจากไฟล์ต้นฉบับ: `Reaction Wheel Balance.pdf` (สไลด์นำเสนอ) และ `raction module.xlsx` (รายการอุปกรณ์ + งบประมาณ)

> **⚠️ เปลี่ยนเป็น Arduino Mega 2560 (2026-09-19)** — เอกสารด้านล่างนี้เป็นสรุปจากสไลด์ต้นฉบับที่ยังระบุ ESP32-C3 อยู่ (คงไว้ตามต้นฉบับเพื่ออ้างอิง) แต่โปรเจคจริงเปลี่ยนคอนโทรลเลอร์เป็น **Arduino Mega 2560** อย่างถาวรแล้ว เหตุผล: ขา DIR/BRAKE ของไดร์เวอร์ BLDC-3640 เป็น 5V logic ที่มี pull-up แรง ESP32 (3.3V) ดึงลงไม่ได้ต้องใช้ทรานซิสเตอร์ช่วย ส่วน Mega (5V logic) ต่อตรงได้เลย ดูรายละเอียดทั้งหมดที่ `hardware/wiring.md` และ `firmware/README.md`

## ข้อมูลโครงงาน
- **ชื่อโครงงาน:** Reaction Wheel Balance
- **ผู้จัดทำ:** ทักษ์ดนัย ยามา (116730205031-1), เรืองโรจน์ ผิวเกลี้ยง (116730205065-9)
- **อาจารย์ที่ปรึกษา:** ผศ.ดร. สุรชาติ จันทร์ชิต

## ความเข้าใจต่อโปรเจค
โปรเจคนี้ **ไม่ใช่หุ่นยนต์ทรงตัวแบบสองล้อขับเคลื่อนบนพื้น** แต่เป็นการทรงตัวด้วย **ล้อเหวี่ยงปฏิกิริยา (Reaction Wheel)** — ใช้หลักการอนุรักษ์โมเมนตัมเชิงมุม: เมื่อมอเตอร์เร่งหมุนล้อ (flywheel) จะเกิดแรงบิดปฏิกิริยาย้อนกลับกระทำต่อโครงสร้าง ทำให้โครงสร้างปรับสมดุล/ต้านการเอียงได้โดยไม่ต้องมีแรงผลักจากภายนอกหรือฐานเคลื่อนที่ (คล้ายหลักการที่ใช้ในดาวเทียมหรือหุ่นยนต์ทรงตัวบนจุดหมุนเดียว)

## ที่มาและความสำคัญ
ระบบควบคุมอัตโนมัติมีบทบาทสำคัญในการจัดการระบบที่ไม่เสถียรโดยธรรมชาติ (เช่น ระบบลูกตุ้มย้อนกลับ/inverted pendulum) วิธีที่มีประสิทธิภาพคือใช้ Reaction Wheel ร่วมกับอัลกอริทึมควบคุม

## วัตถุประสงค์
1. ศึกษาและออกแบบโครงสร้างระบบรักษาสมดุลในแนวแกน X โดยใช้ Reaction Wheel
2. ศึกษาและประยุกต์ใช้เซ็นเซอร์ตรวจจับการเคลื่อนไหว เพื่อวัดมุมเอียงและสภาวะการเคลื่อนที่
3. สร้างพื้นฐานความเข้าใจที่ต่อยอดสู่งานวิจัย/อุตสาหกรรมด้านระบบควบคุมได้

## ขอบเขตโครงงาน
- รักษาสมดุลเมื่อเอียงไม่เกิน **5 องศา**
- ใช้ Reaction Wheel ขนาดเส้นผ่านศูนย์กลาง **20 cm** ควบคุมในแนวแกน X เท่านั้น
- ทดสอบบนพื้นราบเท่านั้น

## แนวคิดการออกแบบ (Concept Design)
ต้นแบบเป็นแผ่นล้อเหวี่ยง (flywheel) ทรงกลม ยึดกับโครงขาตั้งรูปตัว U ขับด้วยมอเตอร์ผ่านชุดเฟือง/สายพานที่ฐาน มีการทดลองออกแบบหลายมุมมอง (isometric, front, side) และมีแนวคิดสำรองแบบแกนหมุนคู่ (dual mounting block ยึดแกนตรงกลาง)

## หลักการทำงาน / ไดอะแกรมระบบ (Control Loop)
```
เซนเซอร์ IMU (ตรวจจับมุมเอียง)
        ↓
หน่วยประมวลผลรับค่าจากเซนเซอร์
        ↓
PID Control → คำนวณคำสั่ง u(t)
        ↓
Motor Driver (ควบคุมความเร็ว + ทิศทางการหมุน)
        ↓
Motor หมุน Reaction Wheel → สร้างโมเมนตัมเชิงมุม
        ↓
Reaction Wheel เพิ่ม/ลดโมเมนตัม → สร้างแรงบิดปฏิกิริยาปรับสมดุลกลับสู่โครงสร้าง (feedback กลับเข้า PID)
```

## อุปกรณ์ที่ใช้ (Hardware)
| อุปกรณ์ | หน้าที่ |
|---|---|
| ESP32-C3 | ไมโครคอนโทรลเลอร์หลัก อ่านค่าเซ็นเซอร์ รันลูป PID สั่งมอเตอร์ |
| MPU-6050 (MPU/IMU) | เซ็นเซอร์วัดมุมเอียง (accelerometer + gyroscope 3 แกน), เชื่อมต่อ I2C |
| BLDC-3640 (BLDC Motor) | มอเตอร์ขับ Reaction Wheel, 12VDC 4000rpm brushless |
| Step-down module | แปลงแรงดันจากแบตเตอรี่ลงมาเป็น 5VDC เลี้ยง ESP32/เซ็นเซอร์ |
| แบตเตอรี่ Li-ion/Li-Po | จ่ายไฟ 12VDC ให้ระบบ |
| Reaction Wheel (พิมพ์ 3D) | แผ่นล้อเหวี่ยงพิมพ์จากเครื่องพิมพ์ 3D |

## การเชื่อมต่อวงจร (Wiring / Pinout)
- **Battery (12VDC)** → Step Down → **+5VDC** เลี้ยง ESP32-C3, MPU/IMU
- **MPU/IMU (I2C):** SDA → GPIO8, SCL → GPIO9, VCC/GND ตามวงจร
- **BLDC Motor:**
  - PWM (ควบคุมความเร็ว) → GPIO1
  - CW/CCW (ทิศทางหมุน) → GPIO2
  - BRAKE (เบรก) → GPIO3
  - สายมอเตอร์: แดง = VCC, ดำ = GND, น้ำเงิน = PWM, เหลือง = ทิศทาง CW/CCW, ส้ม = Brake, เขียว = FG (สัญญาณความเร็วรอบ)
  - **แก้ไข (วัดจากมอเตอร์ตัวจริง 2026-09-19):** แดง = VCC, ดำ = GND, น้ำเงิน = PWM (กลับขั้ว), **เหลือง = FG, ขาว = ทิศทาง, เขียว = Brake** — ไม่มีสายส้ม ดู `hardware/wiring.md`

## รายการอุปกรณ์และงบประมาณ (จาก raction module.xlsx)
| รายการ | จำนวน | ราคา (บาท) | หมายเหตุ/แหล่งซื้อ |
|---|---|---|---|
| BLDC-3640 (มอเตอร์ไร้แปรงถ่าน 12VDC 4000rpm) | 1 | 520 | ortech-online.com |
| DC120-5203M + ชาร์จ 1A (แบตเตอรี่ลิเธียม 12V 18650 มี BMS) | 1 | 535 | shopee.co.th |
| AA451 (โมดูลลดแรงดันไฟ/แปลงไฟ, 4-38VDC เป็น 1.25-36V) | 1 | 95 | ortech-online.com |
| MPU-6050 (โมดูลวัดความเร่ง+ไจโรสโคป 3 แกน, GY-521) | 1 | 90 | ortech-online.com |
| ESP32-C3 Super Mini (WiFi/Bluetooth) | 1 | 120 | ortech-online.com |
| งานพิมพ์ 3D (Reaction Wheel) | 1 | 4,108.80 | — |
| **รวม** | | **5,468.80** | |

### สรุปงบประมาณ
- งบตั้งต้น: **10,000 บาท**
- ค่าใช้จ่าย ณ ปัจจุบัน: **2,734.50 บาท**
- คงเหลือ/ยอดคืนเงิน: **7,265.50 บาท**

> หมายเหตุ: ยอดรวมค่าอุปกรณ์ในตารางบรรทัด (5,468.80) กับค่าใช้จ่าย ณ ปัจจุบันในชีต 2 (2,734.50) ไม่ตรงกัน — อาจเป็นคนละช่วงเวลาบันทึก/ยังจ่ายไม่ครบทุกรายการ ควรเช็คกับต้นฉบับอีกครั้ง

## แผนการดำเนินงาน (ธ.ค. – มี.ค.)
1. วางแผนการดำเนินงาน
2. เข้าพบอาจารย์ที่ปรึกษา
3. ศึกษาและรวบรวมข้อมูลที่เกี่ยวข้อง
4. ออกแบบตัวชิ้นงานต้นแบบ เสนอที่ปรึกษาโครงงาน
5. ออกแบบต้นแบบระบบควบคุม เสนออาจารย์ที่ปรึกษา
6. นำเสนอหัวข้อโครงงาน
7. ปรับปรุงแก้ไข

## การเก็บผลการทดลอง
1. ทำกราฟทดลองการทำงานของระบบทั้งหมด 4 แบบ ตามความเร็วรอบที่แตกต่างกัน เพื่อหาค่าที่เหมาะสมที่สุด
2. ทำกราฟเปรียบเทียบผลการทำงานแบบปกติ กับกรณีที่มีสิ่งรบกวน (disturbance)

## ผลที่คาดว่าจะได้รับ
1. ความรู้เกี่ยวกับการใช้ Reaction Wheel รักษาสมดุลในแนวแกน X
2. ต้นแบบ Reaction Wheel เป็นพื้นฐานต่อยอดการรักษาสมดุลในงานอื่น ๆ
3. ประสบการณ์พัฒนาโปรแกรมควบคุมแบบเรียลไทม์ที่ใช้งานจริงได้

## ส่วนที่ยังไม่มีข้อมูล (ว่างในสไลด์ต้นฉบับ)
- ทบทวนเอกสารและงานวิจัยที่เกี่ยวข้อง (หน้า 5 — ว่าง)
- สรุปและข้อเสนอแนะ (หน้า 16 — ว่าง)

ส่วนเหล่านี้และค่า PID/โค้ดจริง ยังไม่ได้ระบุในไฟล์ต้นฉบับ รอข้อมูลเพิ่มเติมจากผู้ใช้ในภายหลัง
