OAKHEN1412/reaction-wheel-balance/project-overview.html

Control systems project · Arduino Mega 2560 · MPU-6050 · BLDC-3640

# Reaction Wheel Balance

โครงตัว U ที่ทรงตัวบนขอบฐานด้วยล้อเหวี่ยง 20 cm — เร่งหรือชะลอล้อเพื่อสร้างแรงบิดปฏิกิริยาดันโครงกลับสู่แนวตั้ง อ่านมุมจาก IMU แล้วคำนวณคำสั่งมอเตอร์ที่ 500 Hz

ผู้จัดทำ

ทักษ์ดนัย ยามา
เรืองโรจน์ ผิวเกลี้ยง

ที่ปรึกษา

ผศ.ดร. สุรชาติ จันทร์ชิต

ขอบเขต

เอียง ≤ 5° · แกน X · พื้นราบ

สถานะ

ออกแบบ + จำลองเสร็จ

Status

## ตอนนี้อยู่ตรงไหน

วงจร + เฟิร์มแวร์พร้อมแฟลช

compile ผ่านทั้ง 3 sketch (ใช้ flash 27%) ตรวจโค้ดและแก้ครบแล้ว

วิธีควบคุมใช้ได้ในจำลอง

ฟื้นจากเอียง 5° ได้ 19/20 รอบ ในแบบจำลองที่มี noise และ delay

ฮาร์ดแวร์จริงยังไม่ได้ทดสอบ

ต้องวัดขั้วสัญญาณมอเตอร์ แกน IMU อัตราทด และมวลจริงก่อน

ลุกขึ้นเองจากท่านอนทำไม่ได้กับมอเตอร์ตัวนี้ — เบรกหยุดล้อได้ช้าเกินไป (ต้องการ 190–770 rad/s² แต่มอเตอร์ทำได้ราว 78 rad/s²) ต้องประคองให้ตั้งตรงก่อน แล้วระบบจะทรงตัวต่อเอง

Hardware

## อุปกรณ์ที่ใช้จริง

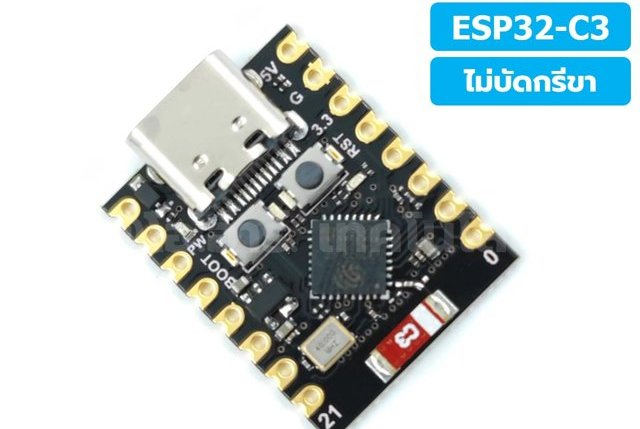
[picture p1: assets/modules/esp32c3.jpg]
บอร์ด ESP32-C3 Super Mini (คอนโทรลเลอร์รุ่นเดิม ถูกแทนที่แล้ว)


### Arduino Mega 2560

สมองของระบบ รันลูปควบคุม 500 Hz · ลอจิก 5 V · รับไฟ VIN ตรงจากแบต 12 V · เปลี่ยนจาก ESP32-C3 เมื่อ 2026-09-19 (ยังไม่มีรูปจริง รูปด้านซ้ายเป็นบอร์ดรุ่นเดิม)

D11 PWM · D7 DIR · D6 BRAKE · D2 FG · D20/D21 I²C

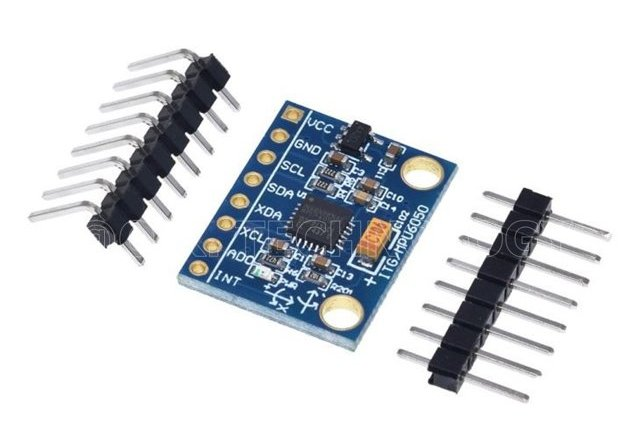
[picture p2: assets/modules/mpu6050.jpg]
โมดูล MPU-6050 GY-521 พร้อมขา header


### MPU-6050 (GY-521)

accelerometer + gyroscope 3 แกน ใช้วัดมุมเอียงและอัตราเอียง · ตั้ง ±4 g / ±500 °/s

SDA→8 · SCL→9 · INT→10 · addr 0x68

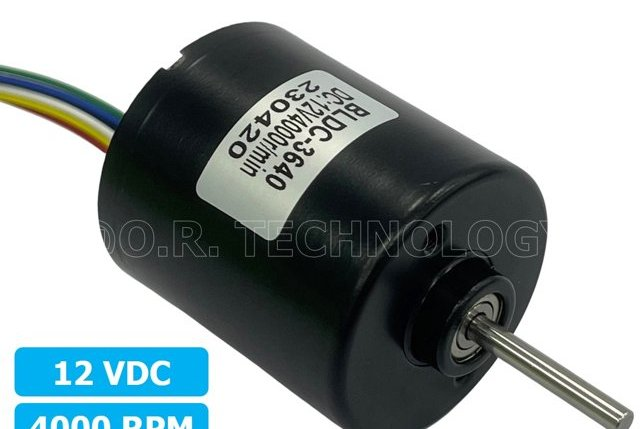
[picture p3: assets/modules/bldc3640.jpg]
มอเตอร์ BLDC-3640 สีดำ มีสายไฟ 6 เส้น


### BLDC-3640

มอเตอร์ไร้แปรงถ่าน 12 VDC 4000 rpm มีไดรเวอร์ในตัว สาย 6 เส้น ขับล้อผ่านเฟือง

PWM→1 · F/R→2 · BRAKE→3 · FG→4

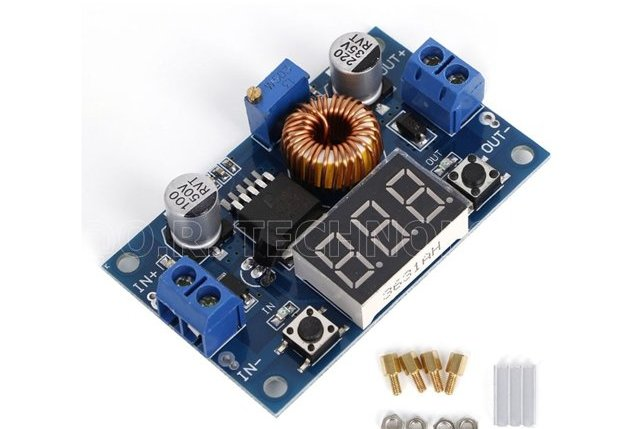
[picture p4: assets/modules/aa451.jpg]
โมดูลลดแรงดัน AA451 พร้อมจอแสดงผลแรงดัน 3 หลัก (ไม่ใช้แล้วในวงจรปัจจุบัน)


### AA451 Step-down ไม่ใช้แล้ว

XL4015 · รับ 4–38 V ออก 1.25–36 V 5 A · ซื้อไว้ตอนออกแบบกับ ESP32-C3 แต่ Arduino Mega รับ VIN 12 V ตรงได้เลย (onboard regulator) จึงไม่ต้องใช้ตัวนี้อีก

เดิม: IN 12 V → OUT 5 V → ESP32 5V

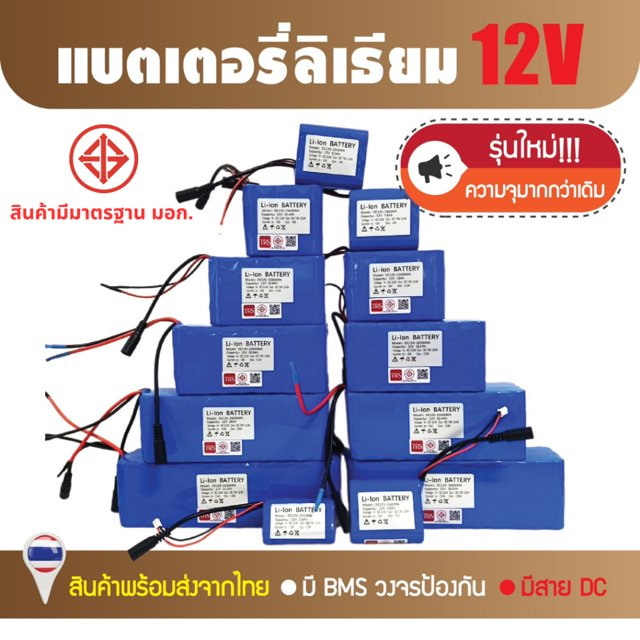
[picture p5: assets/modules/battery12v.jpg]
แบตเตอรี่ลิเธียม 12V แพ็ค 18650 หลายขนาด พร้อมสาย DC


### แบต Li-ion 12 V (DC120-5203M)

แพ็ค 18650 แบบ 3S มี BMS + ที่ชาร์จ 1 A · ห้ามใช้จนแรงดันต่ำกว่า 9 V

+12 V → สวิตช์ → ฟิวส์ 3 A

รูปจากหน้าร้านที่สั่งซื้อตามไฟล์ raction module.xlsx (ร้าน โอ.อาร์. เทคโนโลยี และ Shopee) — รูป ESP32 และแบตในสไลด์เดิมไม่ตรงรุ่นที่ใช้จริง (สไลด์เป็นบอร์ด DevKit และแบต 24 V) · คอนโทรลเลอร์เปลี่ยนจาก ESP32-C3 เป็น Arduino Mega 2560 ถาวรเมื่อ 2026-09-19 (ยังไม่มีรูปโมดูล Mega จริงในชุดนี้)

### โครงสร้างที่ออกแบบ (Fusion)

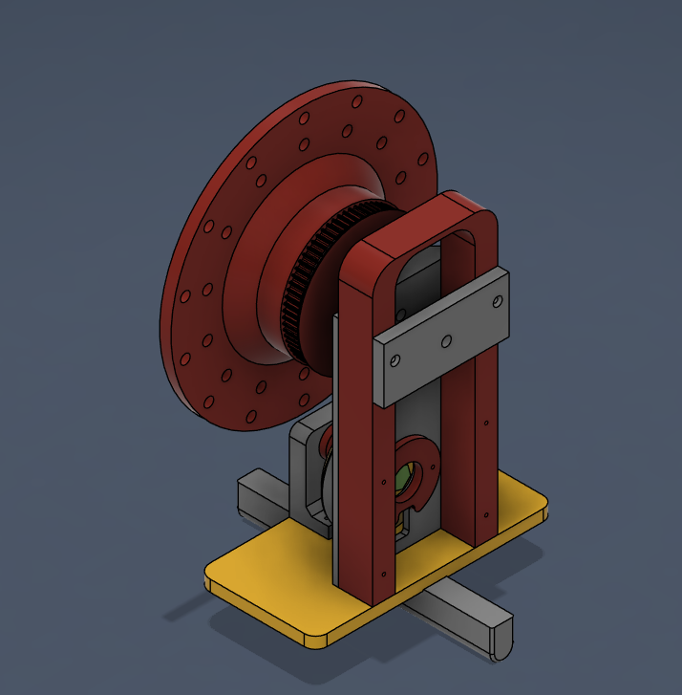
[picture p6: assets/cad/iso.png]
ภาพ CAD มุมเอียง: ล้อเหวี่ยงสีแดงบนโครงตัว U ฐานสีเหลือง


มุมเอียง

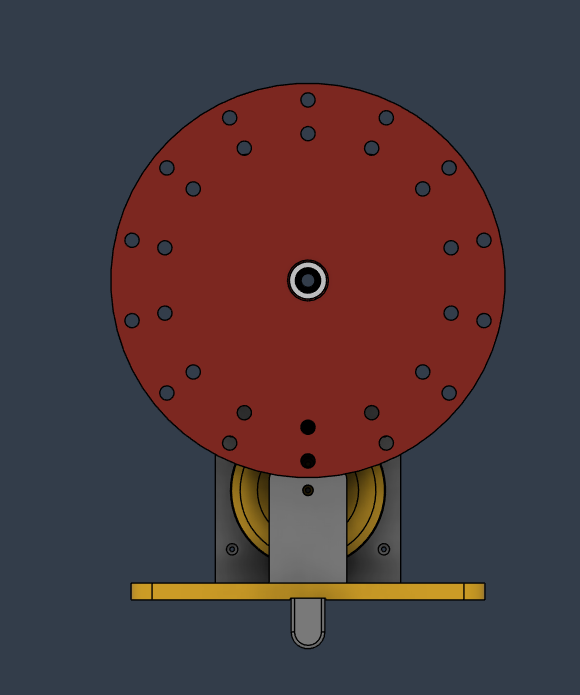
[picture p7: assets/cad/front.png]
ภาพ CAD ด้านหน้า แสดงล้อเหวี่ยงเต็มวง


ด้านหน้า

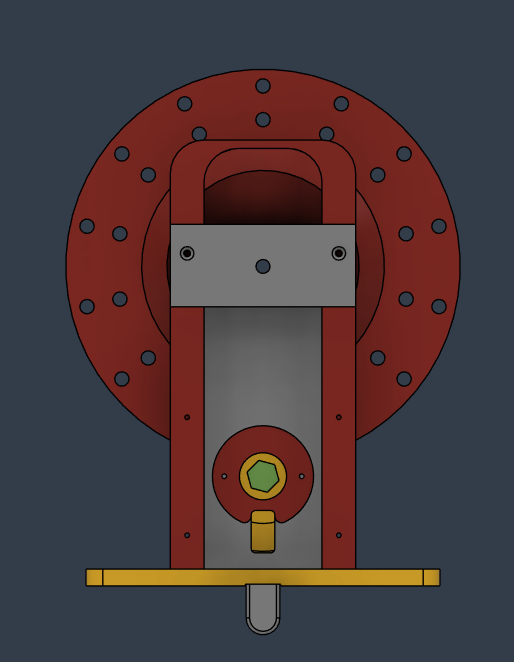
[picture p8: assets/cad/back.png]
ภาพ CAD ด้านหลัง แสดงโครงตัว U และพูลเลย์มอเตอร์


ด้านหลัง

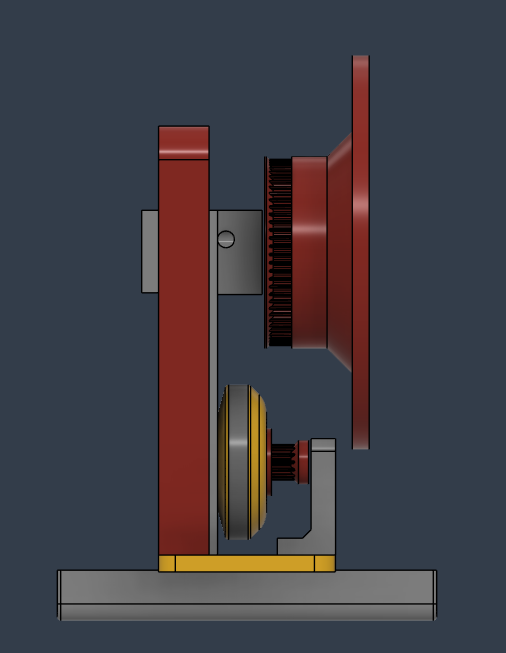
[picture p9: assets/cad/side.png]
ภาพ CAD ด้านข้าง แสดงเฟืองล้อด้านบนและมอเตอร์ด้านล่าง


ด้านข้าง · มอเตอร์ล่าง

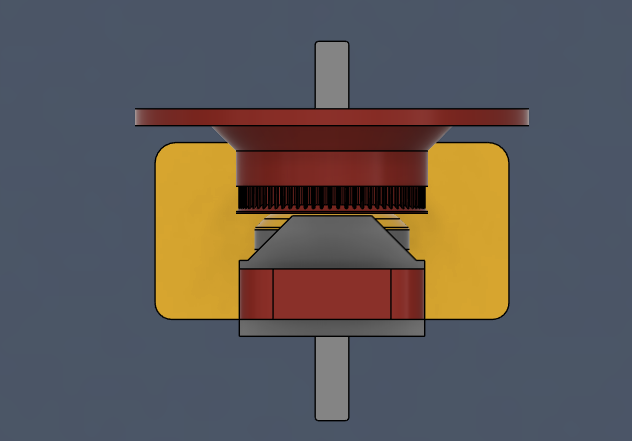
[picture p10: assets/cad/top.png]
ภาพ CAD มองจากด้านบน


ด้านบน

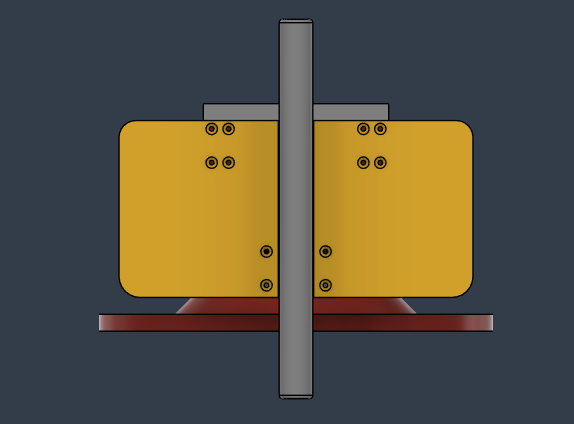
[picture p11: assets/cad/bottom.png]
ภาพ CAD มองจากด้านล่าง แสดงแผ่นฐานและแกน


ด้านล่าง · ฐาน

Control loop

## หลักการควบคุม

ลูปทำงานที่ 500 Hz บน Arduino Mega 2560 · เส้นประสีแดงคือสัญญาณป้อนกลับ

แรงบิดที่ดันโครงมาจาก ความเร่งของล้อ ไม่ใช่ความเร็วของล้อ ส่วนไดรเวอร์ในตัวมอเตอร์รับค่าเป็นคำสั่งความเร็ว เฟิร์มแวร์จึงคำนวณความเร่งที่ต้องการก่อน แล้วค่อยสะสมเป็นคำสั่งความเร็ว — การแปลงมุมเป็น PWM ตรง ๆ แบบ PID ทั่วไปจะทรงตัวไม่ได้

เทอม Kw·ω ดึงความเร็วล้อไม่ให้ไหลขึ้นไปจนเต็มรอบ ส่วนทิศการหมุนของล้อประมาณจากโมเดลหน่วงเวลาของมอเตอร์ เพราะสัญญาณ FG บอกได้แค่ขนาดความเร็ว ไม่บอกทิศ

a = Kp·θ + Kd·θ̇ + Kw·ω_w + Ki·∫θ
ω_cmd ← clamp(ω_cmd + a·dt)
duty = |ω_cmd| / ω_fullscale
F/R = sign(ω_cmd) // กลับทิศเมื่อ duty = 0 เท่านั้น

Wiring

## การต่อวงจร

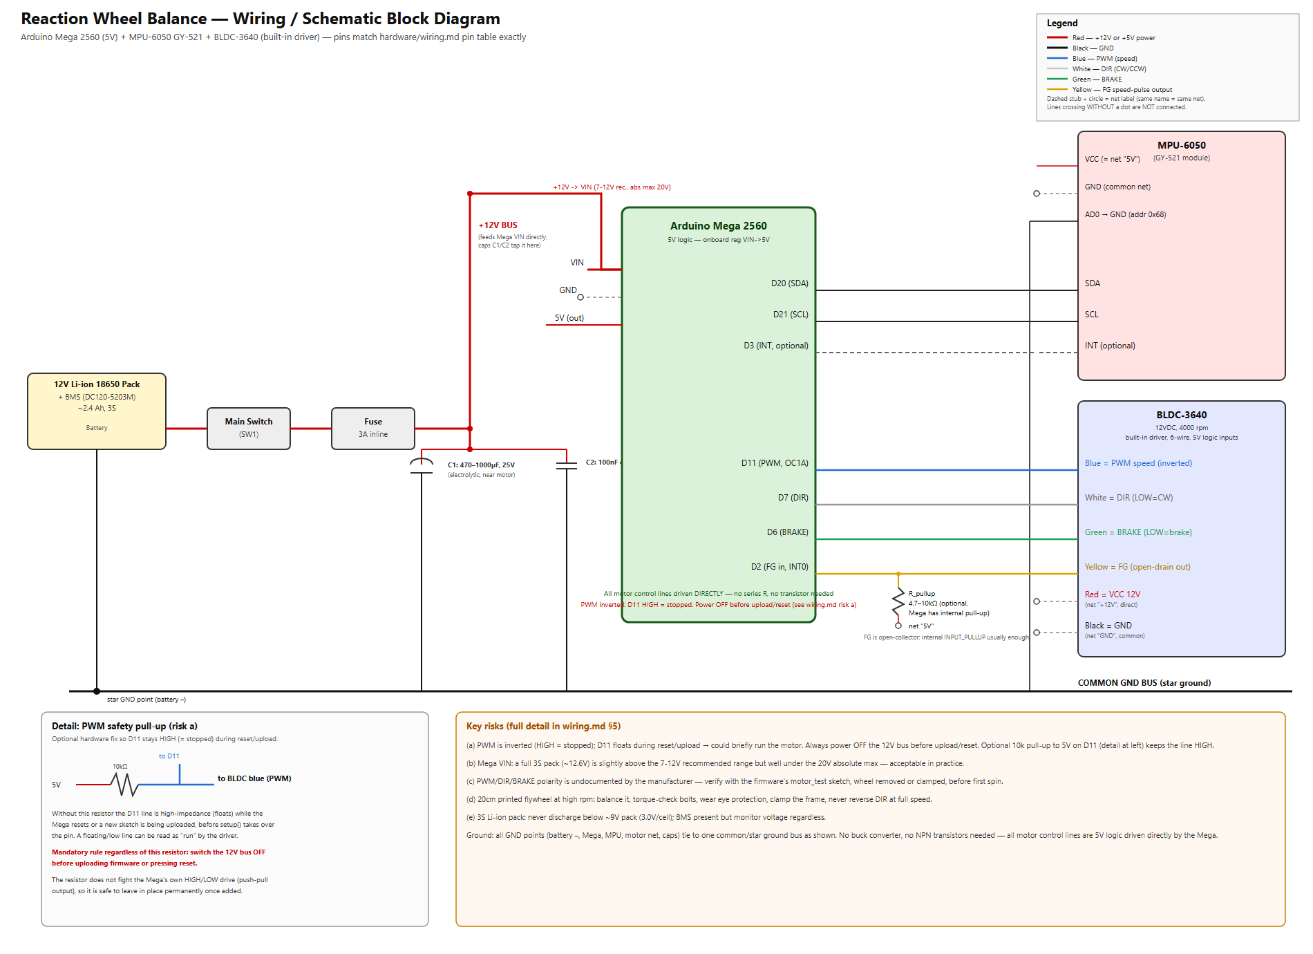
[picture p12: hardware/schematic.png]
แผนผังวงจร: แบตเตอรี่ 12V ผ่านสวิตช์และฟิวส์ ไปมอเตอร์ BLDC และเข้าขา VIN ของ Arduino Mega 2560 โดยตรง ซึ่งต่อกับ MPU-6050 และสายควบคุมมอเตอร์


ไฟล์ต้นฉบับ hardware/schematic.svg · รายละเอียดเต็มใน hardware/wiring.md

สัญญาณ | Mega 2560 | สาย / ขา | หมายเหตุ
I²C SDA | D20 | MPU SDA | fixed I²C pins บน Mega · pull-up ในตัวบอร์ดไป 5V
I²C SCL | D21 | MPU SCL | ไม่ใช่ strapping pin เหมือน ESP32 — ไม่มีข้อจำกัดเรื่อง boot
IMU INT | D3 | MPU INT | ไม่บังคับ
ความเร็วมอเตอร์ | D11 | น้ำเงิน · PWM | ~15.6 kHz · 10-bit · กลับขั้ว (HIGH = หยุด)
ทิศทาง | D7 | ขาว · DIR | LOW = CW · ต่อตรงจาก Mega ได้เลย ไม่ต้องมีทรานซิสเตอร์
เบรก | D6 | เขียว · BRAKE | LOW = เบรก · ต่อตรง ไม่ต้องมีทรานซิสเตอร์
ความเร็วล้อ | D2 | เหลือง · FG | INT0 · ใช้ internal pull-up ของ Mega ไป 5V ได้เลย
ไฟมอเตอร์ | — | แดง / ดำ | 12 V ตรงจากแบต ผ่านสวิตช์ + ฟิวส์ 3 A · C 470–1000 µF ใกล้มอเตอร์
ไฟบอร์ด | VIN | +12V bus ตรง | Mega มี onboard regulator แปลง VIN→5V ในตัว ไม่ต้องมี buck converter แยก · GND ทุกจุดต่อรวมกัน

Bring-up

## ขั้นตอนทดสอบกับเครื่องจริง

1. ต่อวงจรตาม checklist
  เช็คขั้วแบต · ต่อ VIN ของ Mega เข้า +12V bus โดยตรง (ห้ามต่อขา 5V) · สายควบคุมมอเตอร์ทั้งหมดต่อตรงจาก Mega ได้เลย ไม่ต้องมี R หรือทรานซิสเตอร์คั่น · ปิดไฟ 12V ก่อนอัปโหลด/รีเซ็ตบอร์ดทุกครั้ง (PWM กลับขั้ว)
2. แฟลช imu_test
  เอียงโครงด้วยมือตามแกนที่ต้องทรงตัว ดูว่าคอลัมน์ไหนเปลี่ยนตาม แล้วตั้ง IMU_ACCEL_AXIS_* / IMU_GYRO_* ใน config.h
3. แฟลช motor_test โดยถอดล้อหรือยึดให้แน่น
  หา PWM_INVERT, DIR_CW_LEVEL, BRAKE_ACTIVE_LEVEL · หมุนแกนมอเตอร์ 1 รอบเพื่อนับจำนวนพัลส์ FG · รัน coastdown เพื่อดูว่าต้องเปิด ACTIVE_DECEL_BRAKE หรือไม่
4. วัดของจริงแล้วคำนวณเกนใหม่
  มวลโครงและล้อ ความสูงจุดศูนย์ถ่วง ความเฉื่อยล้อ (จาก Fusion Properties) อัตราทด แล้วรัน py -X utf8 sim/design_gains.py --set m_b=… l_b=… --quick และวางบรรทัด #define ที่ได้ลง config.h
5. แฟลชโค้ดหลัก · zero · เช็คทิศแรงบิดด้วยมือ
  ถือโครงให้แน่นจนสถานะเป็น BALANCING แล้วเอียงเล็กน้อย ล้อต้องดันกลับเข้าแนวตั้ง ถ้าดันไปทางที่เอียงให้พิมพ์ sign -1
6. วางบนพื้น · tel 1 เก็บ CSV · ปรับละเอียด · save
  ห้ามจูนแบบเริ่มจาก Kp = 0 — ถ้า Kp ต่ำกว่าค่าขั้นต่ำ ≈ m·g·l / I_w ล้อจะชนะแรงโน้มถ่วงไม่ได้เลย · ค่าที่ save ลง EEPROM จะทับค่าใน config.h ทุกครั้งที่บูต

Simulation

## ผลจำลองและเกนตั้งต้น

Kp1137(rad/s²)/rad

Kd144.3(rad/s²)/(rad/s)

Kw1.0(rad/s²)/(rad/s)

Ki0.039(rad/s²)/(rad·s)

ออกแบบด้วย LQR ที่ค่าประมาณการ: โครง 0.7 kg · COM สูง 0.11 m · ล้อ 0.35 kg · แกนล้อสูง 0.14 m · ทด 2.5 : 1 · tau_m 0.06 s — เกนทุกตัวเครื่องหมายเดียวกัน และต้องคำนวณใหม่เมื่อรู้ค่าจริง

### ฮาร์ดแวร์แบบไหนถึงรอด — อัตราสำเร็จเมื่อฟื้นจาก 5° (20 รอบต่อกรณี)

ตัวแปรที่เปลี่ยน | ค่า | แรงบิดล้อ / แรงโน้มถ่วง | อัตราสำเร็จ
อัตราทด มอเตอร์ : ล้อ | 1.0 | 0.71× | 0%
| 1.5 | 1.07× | 0%
| 2.0 | 1.42× | 45%
| 3.0 | 2.13× | 95%
แรงบิดสตอลล์มอเตอร์ | 0.06 N·m | 1.18× | 0%
| 0.08 N·m | 1.58× | 95%
| 0.10 N·m | 1.97× | 95%
เวลาตอบสนองมอเตอร์ tau_m | 0.04 s | 1.78× | 100%
| 0.06 s | 1.78× | 95%
| 0.08 s | 1.78× | 80%
| 0.10 s | 1.78× | 0%

กฎจำง่าย: แรงบิดที่ล้อต้องได้ ≥ 1.5 เท่าของแรงโน้มถ่วงที่มุมเอียงสูงสุด → อัตราทด ≥ 3 : 1 · มอเตอร์ตอบสนองภายใน 0.08 s · ฟื้นจาก 10° ไม่ได้ด้วยมอเตอร์ตัวนี้ (อยู่นอกขอบเขต 5° อยู่แล้ว) · ข้อมูลเต็มใน sim/out/hardware_requirements.csv

Risks

## สิ่งที่ต้องระวัง

### PWM กลับขั้ว — เสี่ยงมอเตอร์วิ่งตอน reset/upload

D11 = HIGH คือหยุด แต่ขาลอยตอน Mega รีเซ็ต/อัปโหลดโค้ด อาจถูกอ่านเป็น LOW แล้วมอเตอร์วิ่ง ต้องปิดไฟ 12V ก่อนอัปโหลด/รีเซ็ตทุกครั้ง แนะนำเพิ่ม pull-up 10 kΩ จาก D11 ไป 5V เป็นเซฟตี้เสริม

### ไดรเวอร์อาจชะลอล้อไม่ได้

ไดรเวอร์ราคาถูกมักทำได้แค่ปล่อยไหลเมื่อลด PWM ทำให้แรงบิดสองทิศไม่เท่ากัน ถ้าทดสอบด้วยมือแล้วพบว่า coast-down ช้า ให้เปิด ACTIVE_DECEL_BRAKE

### Polarity ของ PWM/DIR/BRAKE ไม่มีเอกสาร

ผู้ผลิต BLDC-3640 ไม่ระบุ logic ของแต่ละขา ต้องยืนยันด้วย motor_test ก่อนติดตั้งล้อทุกครั้งที่เปลี่ยนมอเตอร์

### ล้อพิมพ์ 3D ที่รอบสูง

ล้อ 20 cm ที่ 1,300+ rpm ต้องถ่วงให้สมดุลและขันน็อตแน่น · สวมแว่นตา · ยึดโครงตอนทดสอบครั้งแรก · แบต 3S ห้ามต่ำกว่า 9 V

Bill of materials

## อุปกรณ์และงบประมาณ

รายการ | หน้าที่ | ราคา (บาท)
BLDC-3640 · 12 V 4000 rpm | ขับล้อเหวี่ยง มีไดรเวอร์ในตัว | 520.00
DC120-5203M + ที่ชาร์จ 1 A | แบต Li-ion 12 V มี BMS | 535.00
AA451 step-down ไม่ใช้แล้ว | ซื้อไว้ตอนแรก — Mega รับ VIN 12 V ตรงได้เลย | 95.00
MPU-6050 (GY-521) | วัดมุมเอียง | 90.00
ESP32-C3 Super Mini แทนที่แล้ว | ซื้อไว้ตอนแรก — เปลี่ยนเป็น Arduino Mega 2560 (2026-09-19) | 120.00
งานพิมพ์ 3D | ล้อเหวี่ยง + โครง | 4,108.80
รวม (ตามรายการซื้อจริงในชีต xlsx) | | 5,468.80

งบตั้งต้น 10,000 บาท · ใช้ไปแล้ว 2,734.50 บาท · คงเหลือ 7,265.50 บาท ตามชีต 2 (ไม่ตรงกับยอดรวมตารางด้านบน ควรเช็คต้นฉบับ) · Arduino Mega 2560 ซื้อเพิ่มภายหลังเพื่อแทน ESP32-C3 (ยังไม่มีราคาลงในชีตต้นฉบับ) · อุปกรณ์ที่ต้องซื้อเพิ่ม: MPU-6050 ตัวใหม่ (ตัวเดิมเสีย), สวิตช์, ฟิวส์ 3 A, ตัวเก็บประจุ 470–1000 µF

Repository

## ไฟล์ในโปรเจค

hardware/

wiring.md ตารางขา ลำดับต่อสาย checklist · schematic.svg / .png

firmware/

reaction_wheel_balance/ โค้ดหลัก · imu_test/ · motor_test/ · README.md คำสั่ง serial

sim/

design_gains.py คำนวณเกน · hardware_requirements.py · run_demo.py กราฟ · README.md

Desktop\Projects\self-balancing-robot · Arduino core avr · FQBN arduino:avr:mega
