OAKHEN1412/reaction-wheel-balance/sim/out/hardware_requirements.csv

param | value | torque_margin | success_rate | sat_rate | settle_mean | peak_rpm | gear_ratio | tau_stall_motor | tau_m | omega_max_rpm
gear_ratio | 1.0 | 0.7101104018362732 | 0.0 | 1.0 | nan | 1041.492426617515 | 1.0 | 0.09 | 0.06 | 3999.9999999999995
gear_ratio | 1.5 | 1.0651656027544099 | 0.0 | 1.0 | nan | 1436.2263478189618 | 1.5 | 0.09 | 0.06 | 2666.666666666666
gear_ratio | 2.0 | 1.4202208036725463 | 0.45 | 0.55 | 1.0575555555554947 | 1510.0847989130039 | 2.0 | 0.09 | 0.06 | 1999.9999999999998
gear_ratio | 3.0 | 2.1303312055088197 | 0.95 | 0.0 | 0.565684210526309 | 156.87934132226695 | 3.0 | 0.09 | 0.06 | 1333.333333333333
gear_ratio | 4.0 | 2.8404416073450927 | 0.95 | 0.0 | 0.565684210526309 | 156.87934132226695 | 4.0 | 0.09 | 0.06 | 999.9999999999999
gear_ratio | 6.0 | 4.260662411017639 | 0.95 | 0.0 | 0.565684210526309 | 156.87934132226695 | 6.0 | 0.09 | 0.06 | 666.6666666666665
tau_stall_motor | 0.04 | 0.7890115575958592 | 0.0 | 1.0 | nan | 1156.9161855974867 | 2.5 | 0.04 | 0.06 | 1599.9999999999998
tau_stall_motor | 0.06 | 1.1835173363937888 | 0.0 | 1.0 | nan | 1599.8509917483714 | 2.5 | 0.06 | 0.06 | 1599.9999999999998
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
