OAKHEN1412/reaction-wheel-balance/report/README.md

# ปริญญานิพนธ์ — การออกแบบและพัฒนาระบบควบคุมการทรงตัวด้วยล้อหมุนอัตโนมัติ

ใน git มีเฉพาะ `_source/` และไฟล์นี้ ส่วน `Word/` `PDF/` `รูป/` `_ต้นฉบับเก่า/` อยู่บนเครื่องเท่านั้น (repo เป็นสาธารณะ)

| โฟลเดอร์ | เนื้อหา |
|---|---|
| `Word/` | ไฟล์ที่แก้ไขได้ ได้แก่ หน้าปก, หน้าปกเล่ม (.doc), กิตติกรรมประกาศ, บทที่ 1–5, ภาคผนวก |
| `PDF/` | ฉบับ PDF ของแต่ละส่วน |
| `รูป/` | รูปที่สร้างใหม่ในบทที่ 3–4 และภาคผนวก (ผังการต่อวงจร Nano, กราฟผลการทดลอง, คิวอาร์โค้ด) |
| `_ต้นฉบับเก่า/` | ฉบับก่อนแก้ของบทที่ 3–5 และไฟล์ zip เดิม เก็บไว้อ้างอิง |
| `_source/` | สคริปต์ที่ใช้สร้างกราฟ บทที่ 3–5 และภาคผนวก (อ่าน log จาก `../tuning/logs/`) |

ไม่มีส่วนที่ไฮไลต์สีเหลืองค้างแล้ว (2026-10-13)

แก้ 2026-10-13:
- หัวข้อ 4.5.2 ตารางที่ 4.12 + รูปที่ 4.9 จากการทดสอบผลักด้วยมือ (log: `../tuning/logs/nano_2026-10-13_push_test.log.gz`
  ช่วงที่ 2 คือ t ≥ 752 s, วิเคราะห์ด้วย `../tuning/tools/pushtest.py`) — ข้อมูลชุดนี้เก็บก่อนปรับปรุงตัวประมาณความเร็วล้อ
- เพิ่มผลการปรับปรุงการประมาณทิศทางของความเร็วล้อตามโค้ดล่าสุด (คอมมิต 1758122): หัวข้อ 4.2.4, 4.5.2 ตารางที่ 4.13,
  4.6 ข้อ 3, บทที่ 5 หัวข้อ 5.1.2, 5.1.4 และตารางที่ 5.1 (หัวข้อ 5.2 ปัญหาและอุปสรรค) (log: `nano_2026-10-13_estfix_ab.log.gz`, สคริปต์ `estfix_ab.py`)
- รูปถ่ายต้นแบบจาก iPhone (ส่งผ่าน Taildrop, เก็บใน Downloads ไม่อยู่ใน repo): รูปที่ 4.1 (IMG_5799 + IMG_5790)
  และรูปที่ 3.13 แทนรูปฮาร์ดแวร์เก่า (IMG_5796 + IMG_5794) — ประกอบรูปด้วย `_source/photos.py <โฟลเดอร์รูป>`
- บทที่ 3 หัวข้อใหม่ 3.3.6 การคำนวณและจำลองระบบควบคุม + รูปที่ 3.15 หน้าจอโปรแกรมจำลอง สร้างด้วย
  `_source/sim_mockup.py <โฟลเดอร์ sim ของ repo>` (ตัวเลขทุกตัวรันจาก sim/ จริง ด้วยค่าตั้งต้นช่วงออกแบบ tau_m = 0.06 s)
- ภาคผนวก ก: ซอร์สโค้ดบน GitHub พร้อมคิวอาร์โค้ด (https://github.com/OAKHEN1412/reaction-wheel-balance) และบทที่ 3
  หัวข้อ 3.3.5 อ้างถึงภาคผนวก
- เรียบเรียงภาษาบทที่ 3 และ 4 ใหม่ให้อ่านง่าย (ประโยคสั้น อธิบายศัพท์ตอนใช้ครั้งแรก แยกผลเป็นข้อ ๆ) ตัวเลข ตาราง รูป
  และสมการเหมือนเดิมทุกตัว พร้อมแก้ 2 จุดให้ตรงกับโปรแกรมจริง: เซนเซอร์ไม่ได้ใช้ DMP (โปรแกรมอ่านค่าดิบแล้วรวมด้วยตัวกรอง
  คอมพลีเมนทารีเอง) และตัวควบคุมเป็น PID ร่วมกับการป้อนกลับความเร็วล้อ ไม่ใช่ PID อย่างเดียว · บทที่ 3 แก้ด้วย
  `_source/ch3_rewrite.py` (รันครั้งเดียว) · บทที่ 4 แก้ใน `build4.py` · ฉบับก่อนเรียบเรียงอยู่ใน `_ต้นฉบับเก่า/`
- บทที่ 5 เรียบเรียงภาษาใหม่แบบเดียวกับบทที่ 3-4 (แก้ใน `build5.py`) ตัวเลขและการอ้างอิงตารางเหมือนเดิม ตารางที่ 5.1 ตั้งไม่ให้แถวขาดข้ามหน้า · ฉบับก่อนแก้อยู่ใน `_ต้นฉบับเก่า/`
- ต้นบทที่ 4 เพิ่มส่วน "คำศัพท์และสัญลักษณ์ที่ใช้ในบทนี้" (duty, PWM, FG, Kp/Kd/Ki/Kw, SD ฯลฯ อธิบายแบบภาษาง่าย แบ่ง 4 กลุ่ม)
- `docxlib.thai_breaks` ไม่ตัดบรรทัดชิดวงเล็บหรือเครื่องหมายคำพูดแล้ว (เดิมมีบรรทัดที่ลงท้ายด้วย "(")

สร้างใหม่: คัดลอก `_source/*.py` ไปโฟลเดอร์ทำงาน, แตก log ที่ `figs.py` ใช้ลง `logs/`, สร้างโฟลเดอร์ `out/`,
รัน `figs.py` แล้ว `build4.py` / `build5.py` / `build_appendix.py` (ต้องมี `pythainlp`, `python-docx`, `matplotlib`, `segno`)
จากนั้นส่งออก PDF ด้วย Word · `build3.py` ต้องใช้รูปใน `ch3img/` ซึ่งไม่ได้เก็บไว้ บทที่ 3 ฉบับปัจจุบันจึงแก้ที่ไฟล์ Word โดยตรง
(ข้อความใน `build3.py` ตรงกับฉบับก่อนเรียบเรียงภาษา ฉบับปัจจุบันให้ดู `ch3_rewrite.py`)
