OAKHEN1412/reaction-wheel-balance/sim/out/disturbance_impulse.png

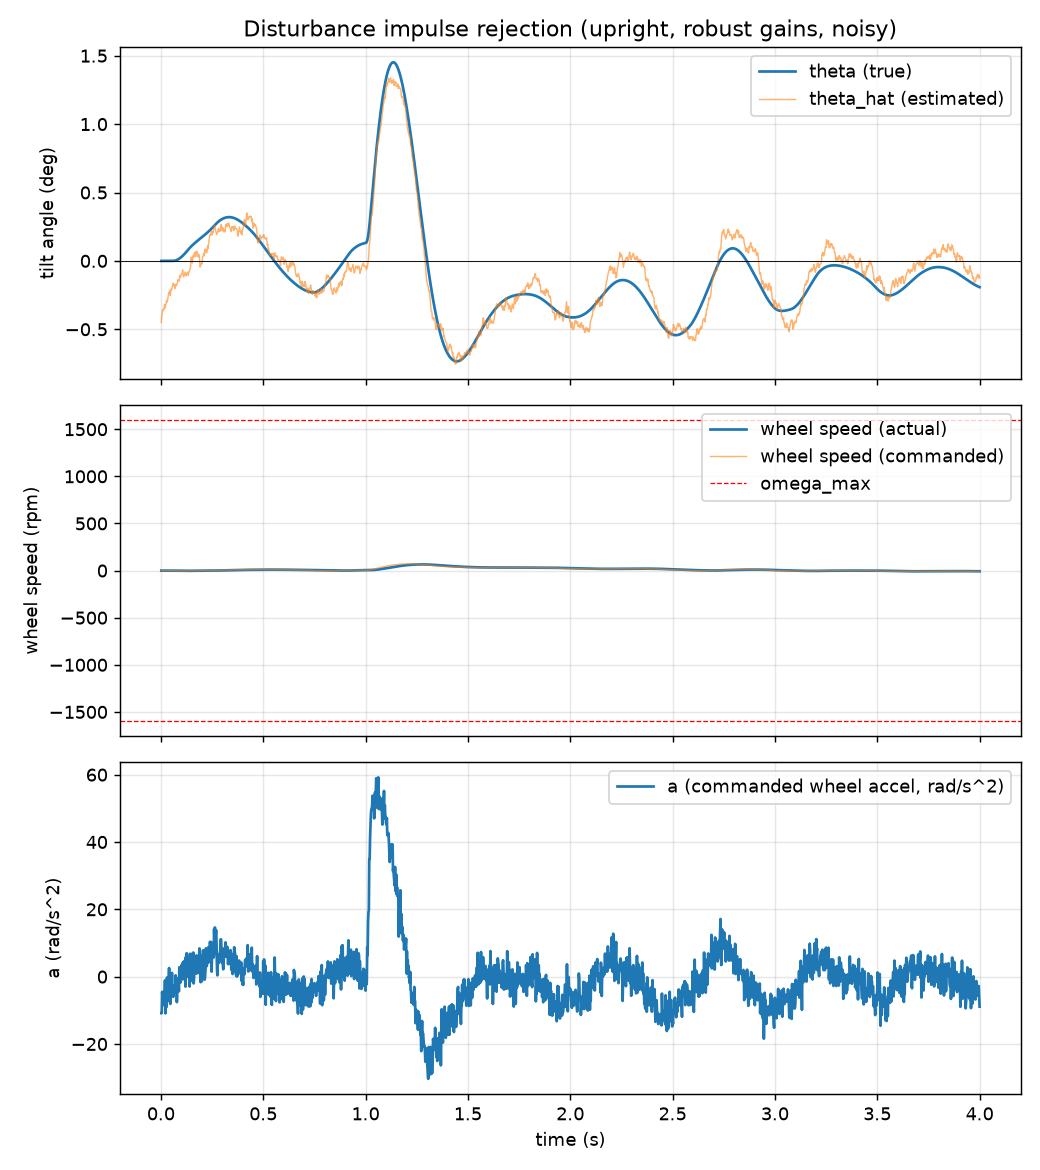
sim/out/disturbance_impulse.png
