OAKHEN1412/reaction-wheel-balance/sim/out/gain_comparison.png

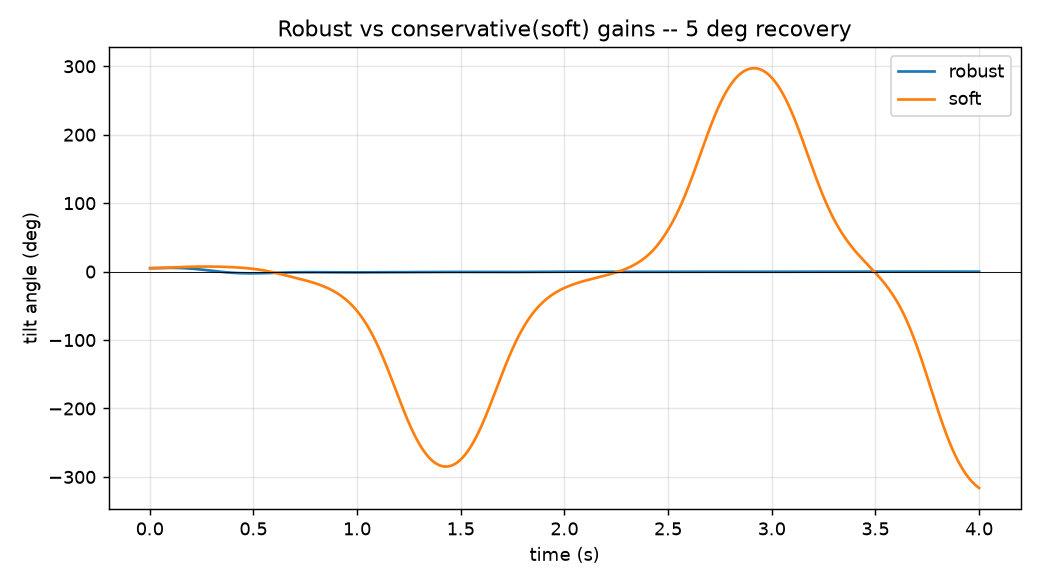
sim/out/gain_comparison.png
