OAKHEN1412/reaction-wheel-balance/sim/out/jumpup/dropout_half_20ms.png

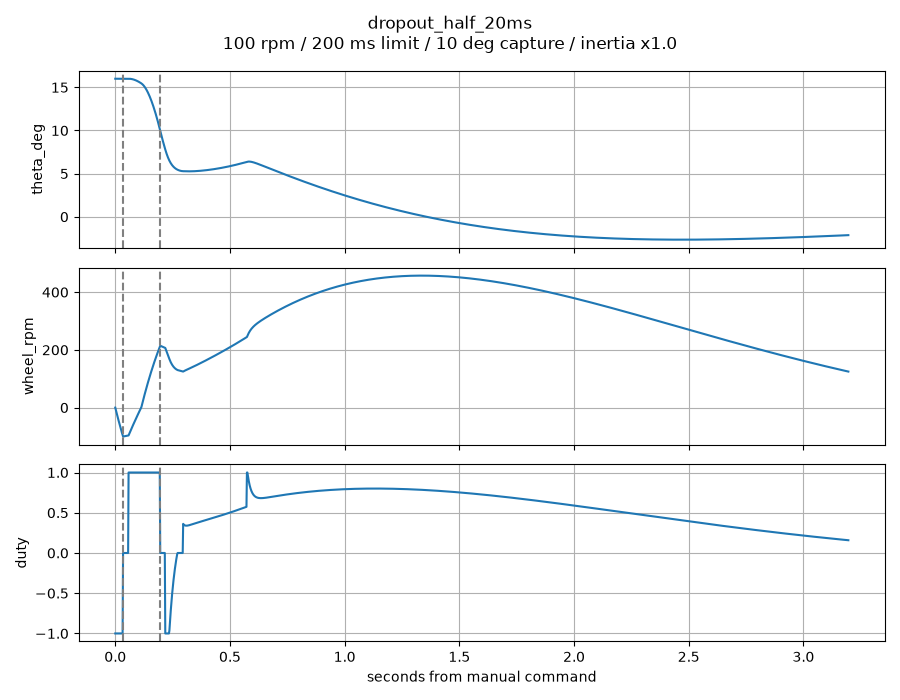
sim/out/jumpup/dropout_half_20ms.png
