OAKHEN1412/reaction-wheel-balance/sim/out/jumpup/dropout_nominal.png

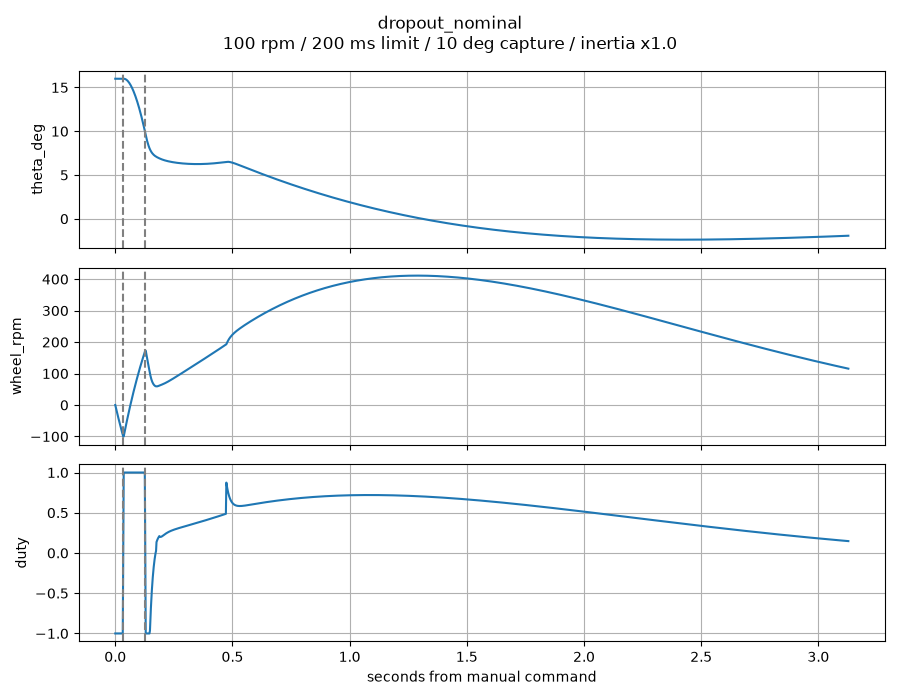
sim/out/jumpup/dropout_nominal.png
