OAKHEN1412/reaction-wheel-balance/sim/out/jumpup/expected_half_20ms_fg_dropout.png

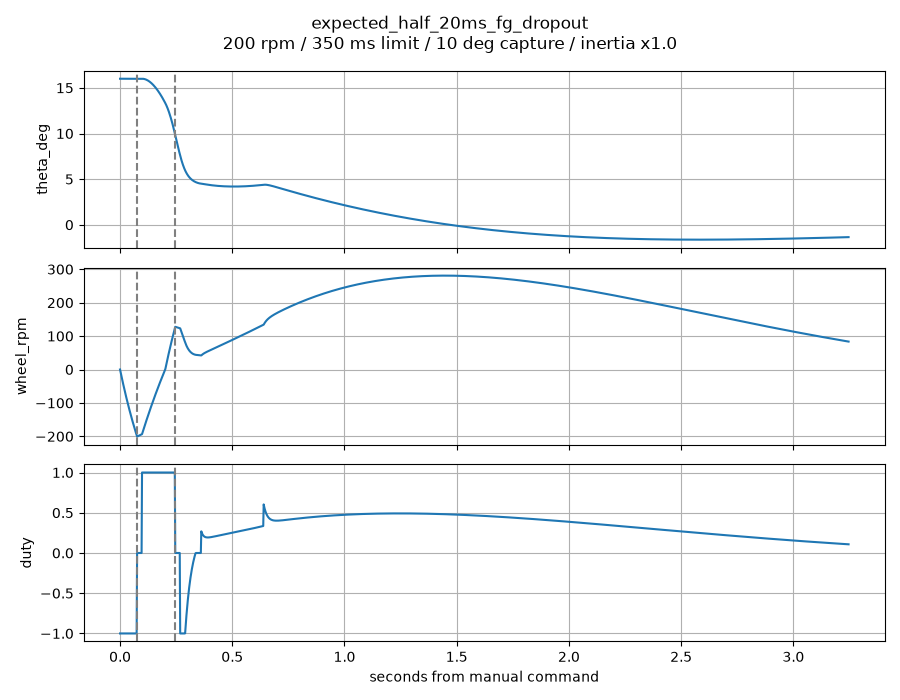
sim/out/jumpup/expected_half_20ms_fg_dropout.png
