OAKHEN1412/reaction-wheel-balance/sim/out/jumpup/expected_half_20ms_ideal.png

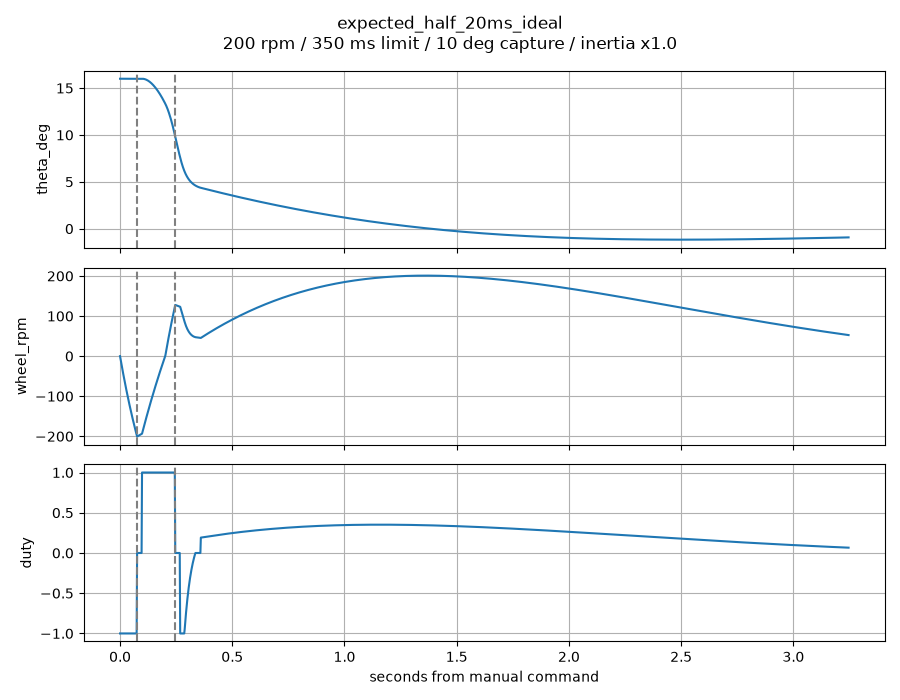
sim/out/jumpup/expected_half_20ms_ideal.png
