OAKHEN1412/reaction-wheel-balance/sim/out/jumpup/expected_nominal_fg_dropout.png

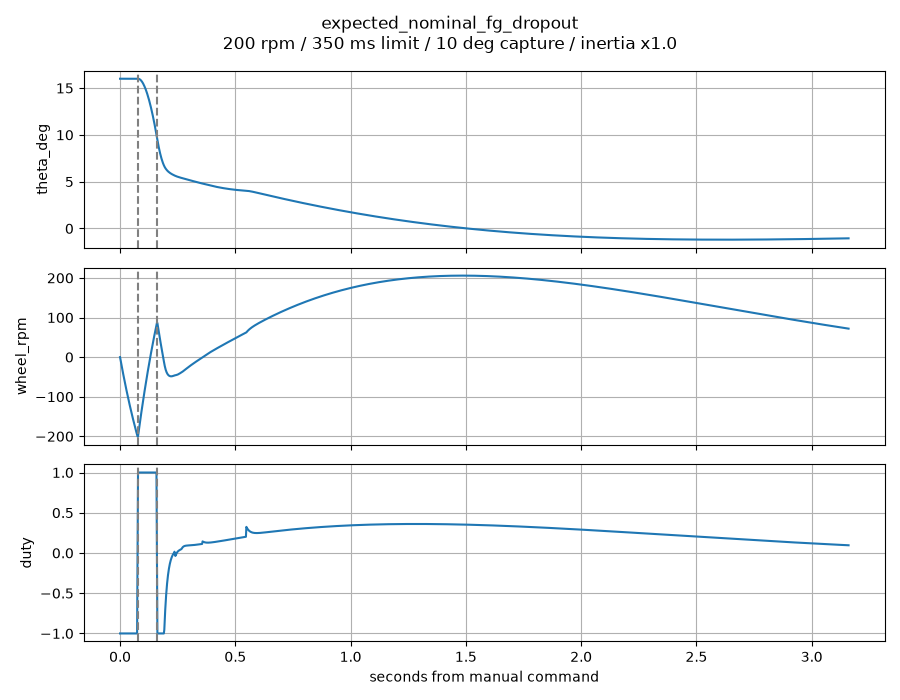
sim/out/jumpup/expected_nominal_fg_dropout.png
