OAKHEN1412/reaction-wheel-balance/sim/out/jumpup/expected_nominal_ideal.png

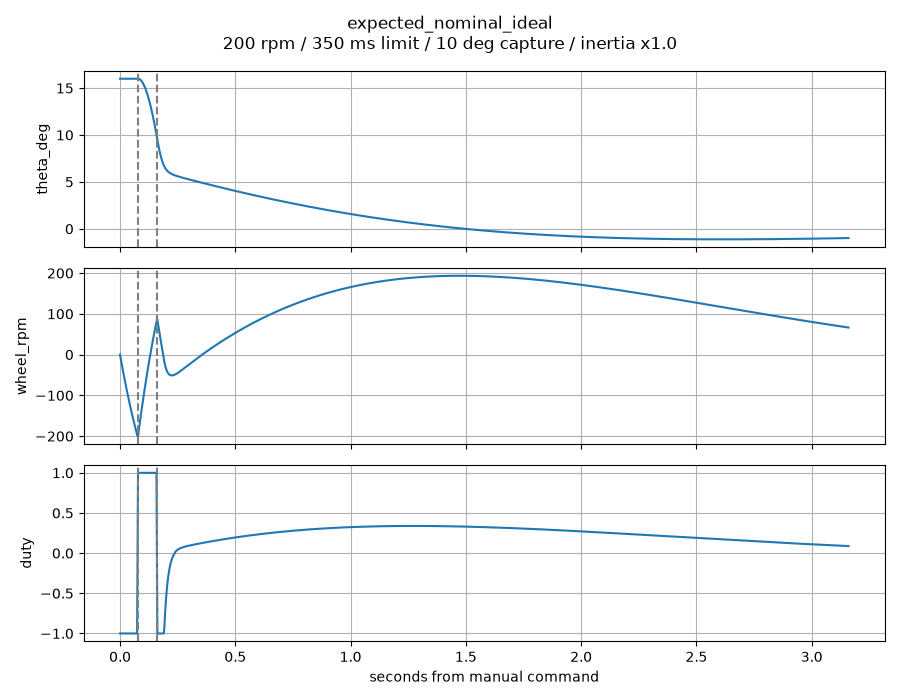
sim/out/jumpup/expected_nominal_ideal.png
