OAKHEN1412/reaction-wheel-balance/sim/out/jumpup/exploratory_v1/safe_pessimistic.png

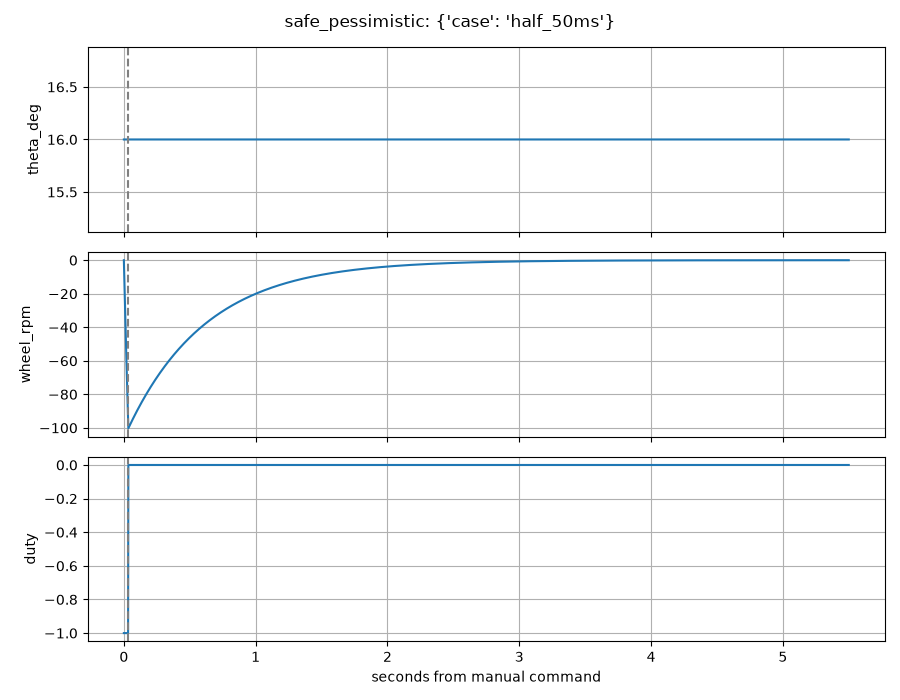
sim/out/jumpup/exploratory_v1/safe_pessimistic.png
