OAKHEN1412/reaction-wheel-balance/sim/out/jumpup/exploratory_v1/thresholds.png

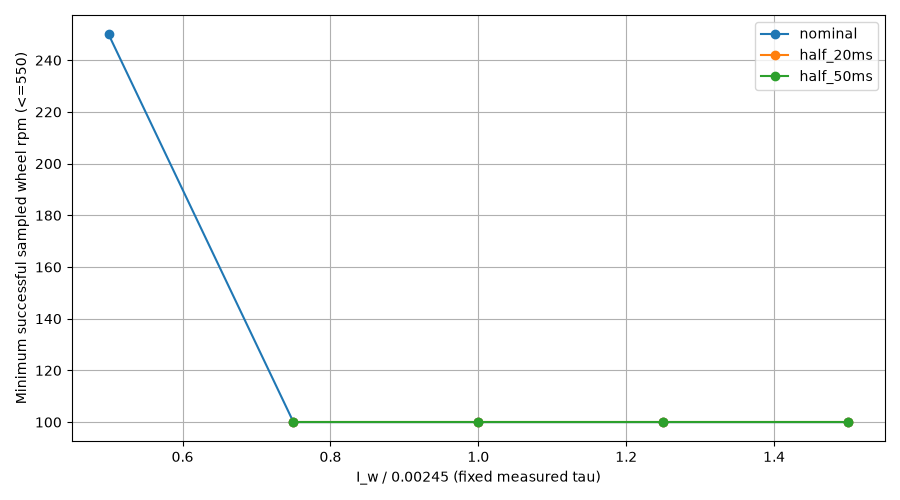
sim/out/jumpup/exploratory_v1/thresholds.png
