OAKHEN1412/reaction-wheel-balance/sim/out/jumpup/exploratory_v1/working_half_20ms.png

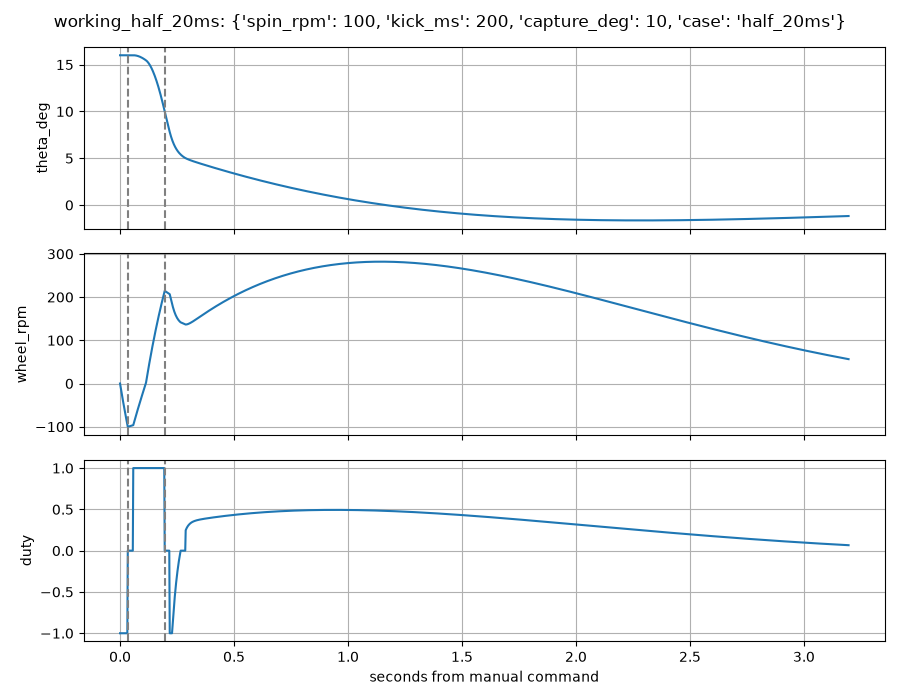
sim/out/jumpup/exploratory_v1/working_half_20ms.png
