OAKHEN1412/reaction-wheel-balance/sim/out/jumpup/exploratory_v1/working_nominal.png

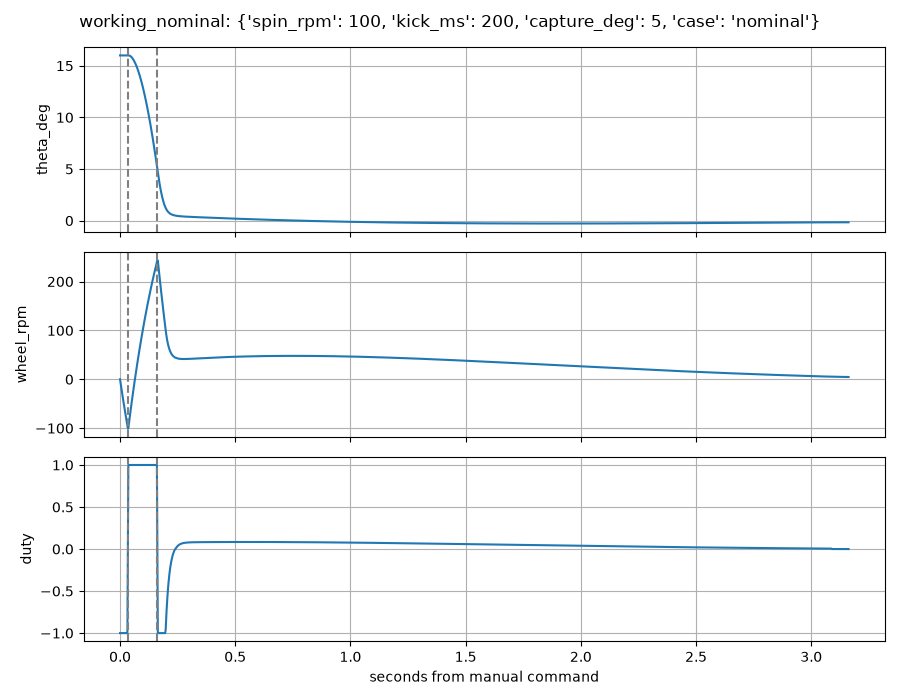
sim/out/jumpup/exploratory_v1/working_nominal.png
