OAKHEN1412/reaction-wheel-balance/sim/out/jumpup/recommended_half_20ms.png

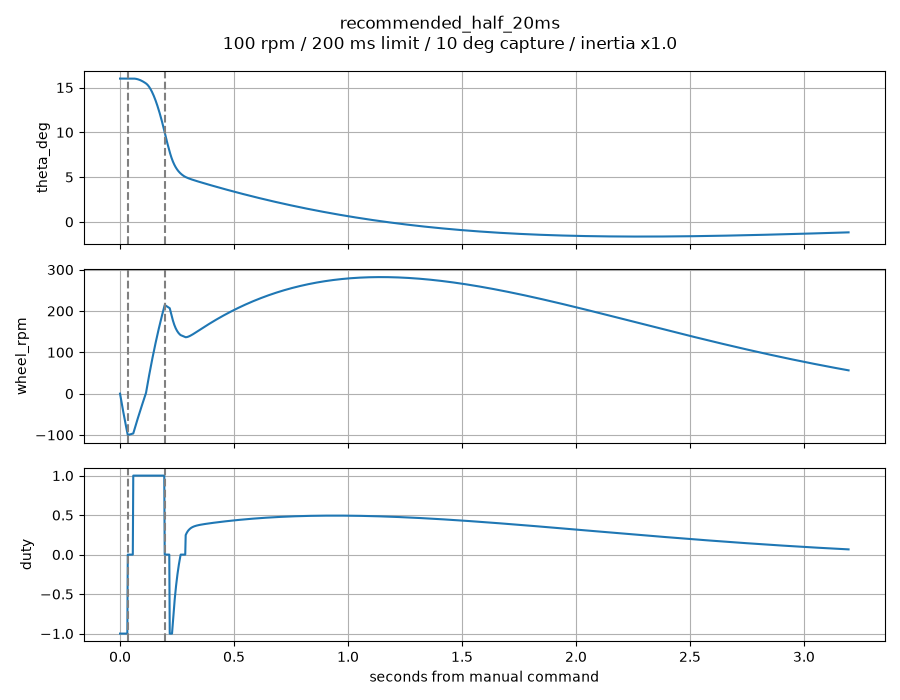
sim/out/jumpup/recommended_half_20ms.png
