OAKHEN1412/reaction-wheel-balance/sim/out/jumpup/recommended_nominal.png

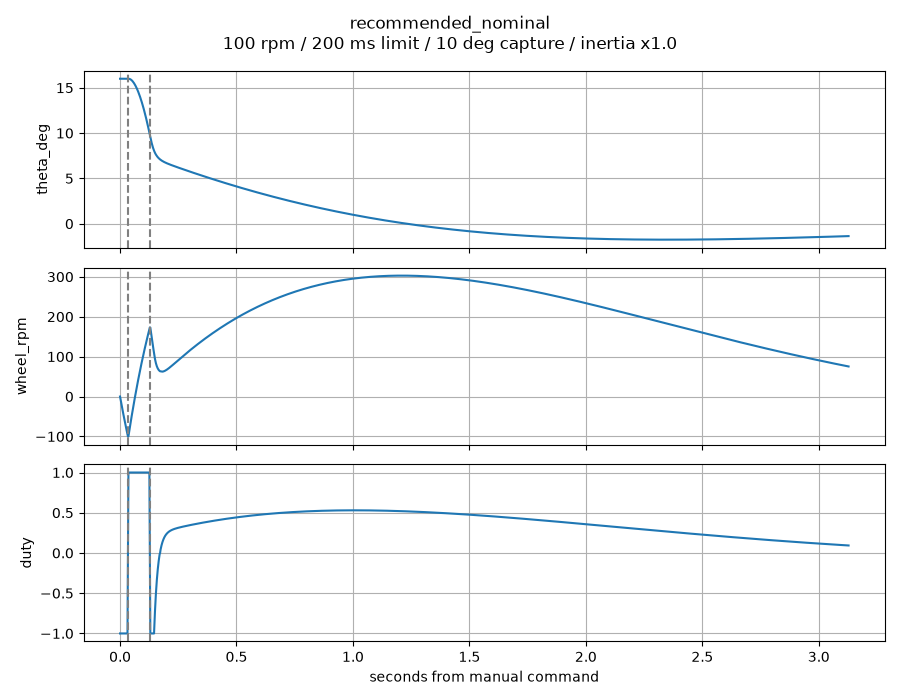
sim/out/jumpup/recommended_nominal.png
