OAKHEN1412/reaction-wheel-balance/sim/out/jumpup/safe_high_inertia.png

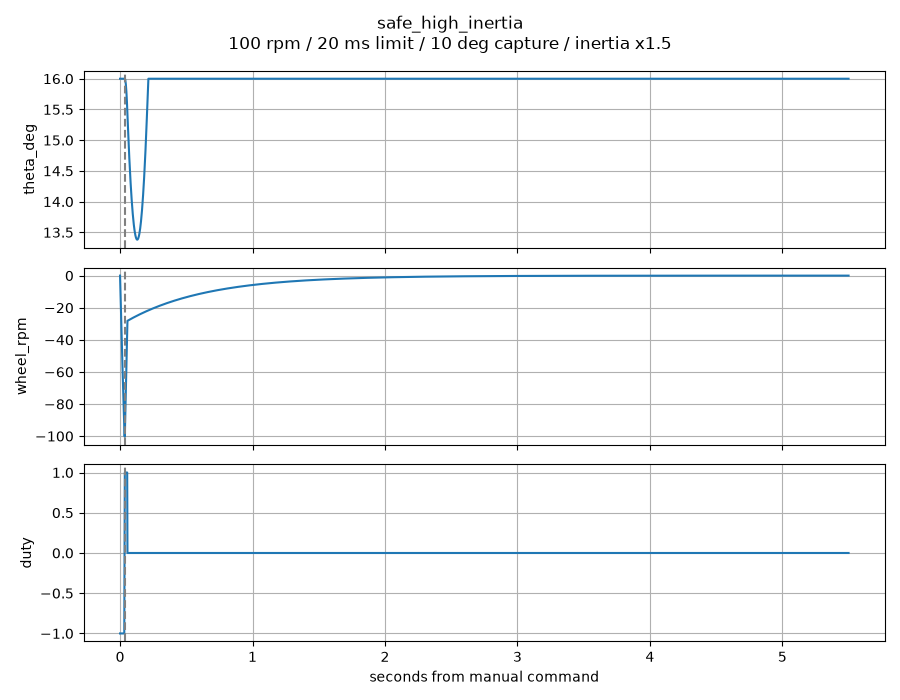
sim/out/jumpup/safe_high_inertia.png
