OAKHEN1412/reaction-wheel-balance/sim/out/jumpup/safe_pessimistic.png

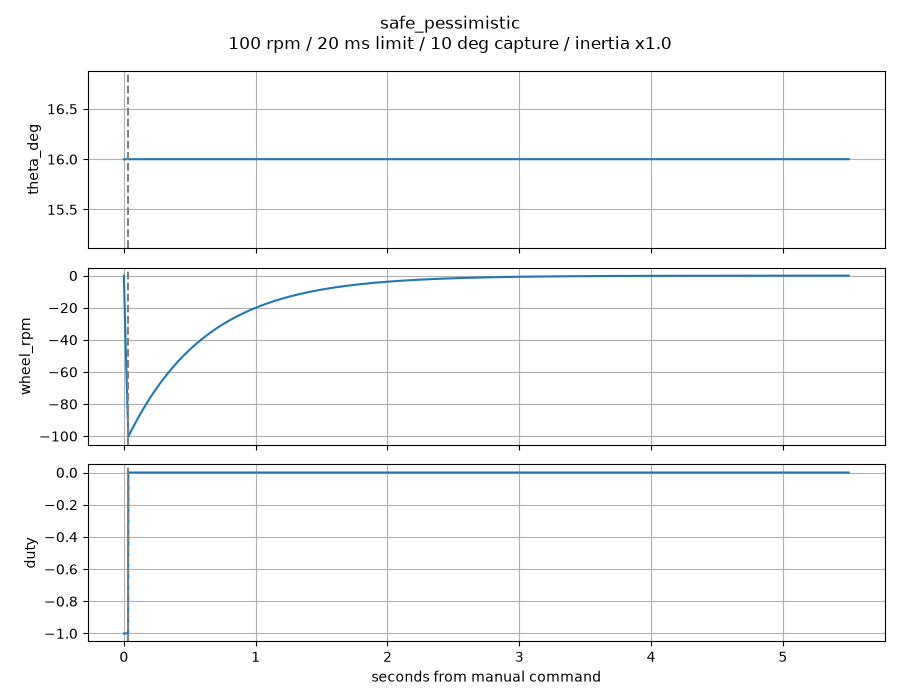
sim/out/jumpup/safe_pessimistic.png
