OAKHEN1412/reaction-wheel-balance/sim/out/recovery_5deg.png

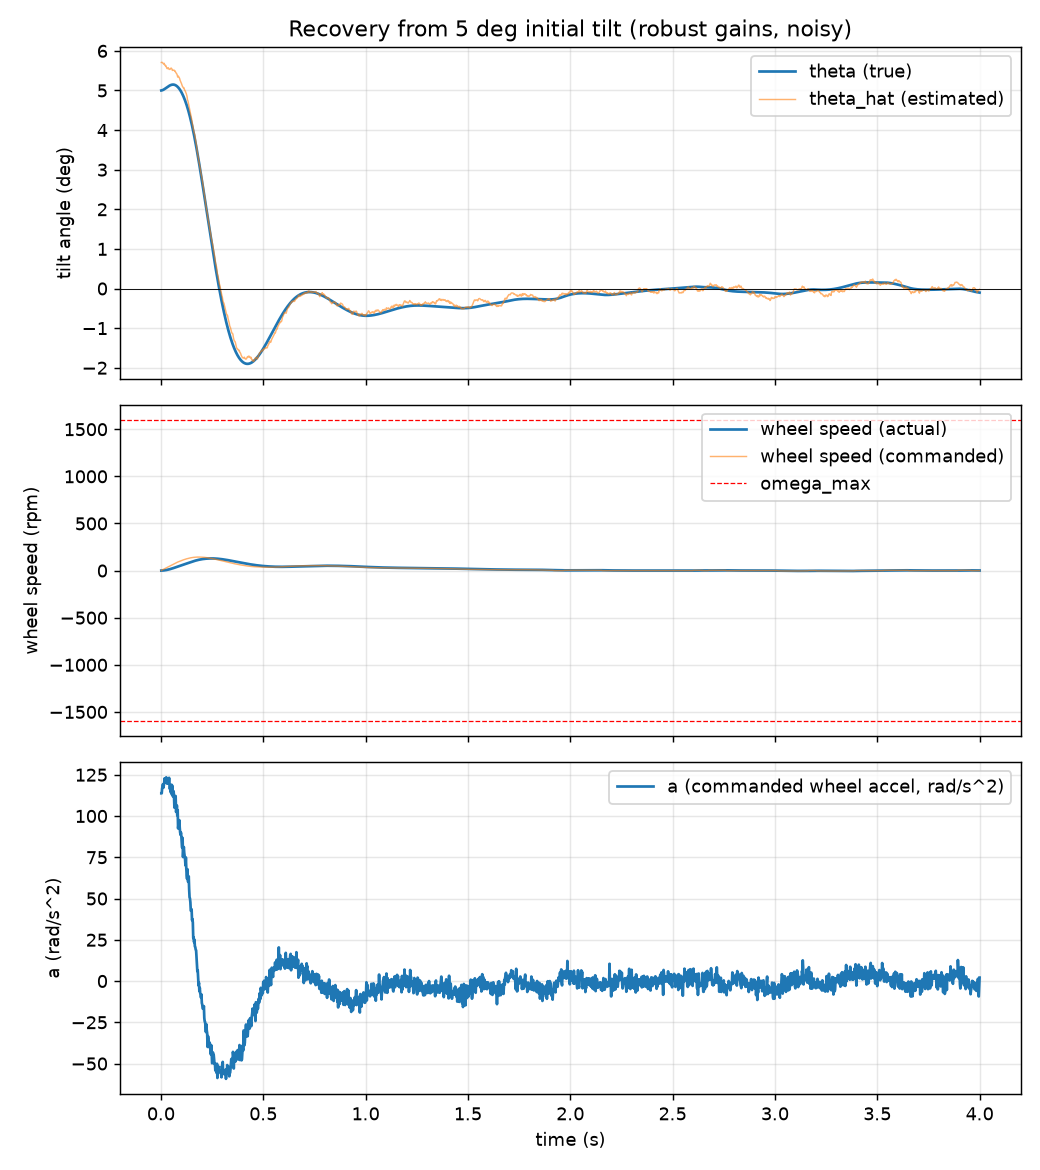
sim/out/recovery_5deg.png
