OAKHEN1412/reaction-wheel-balance/sim/out/recovery_10deg.png

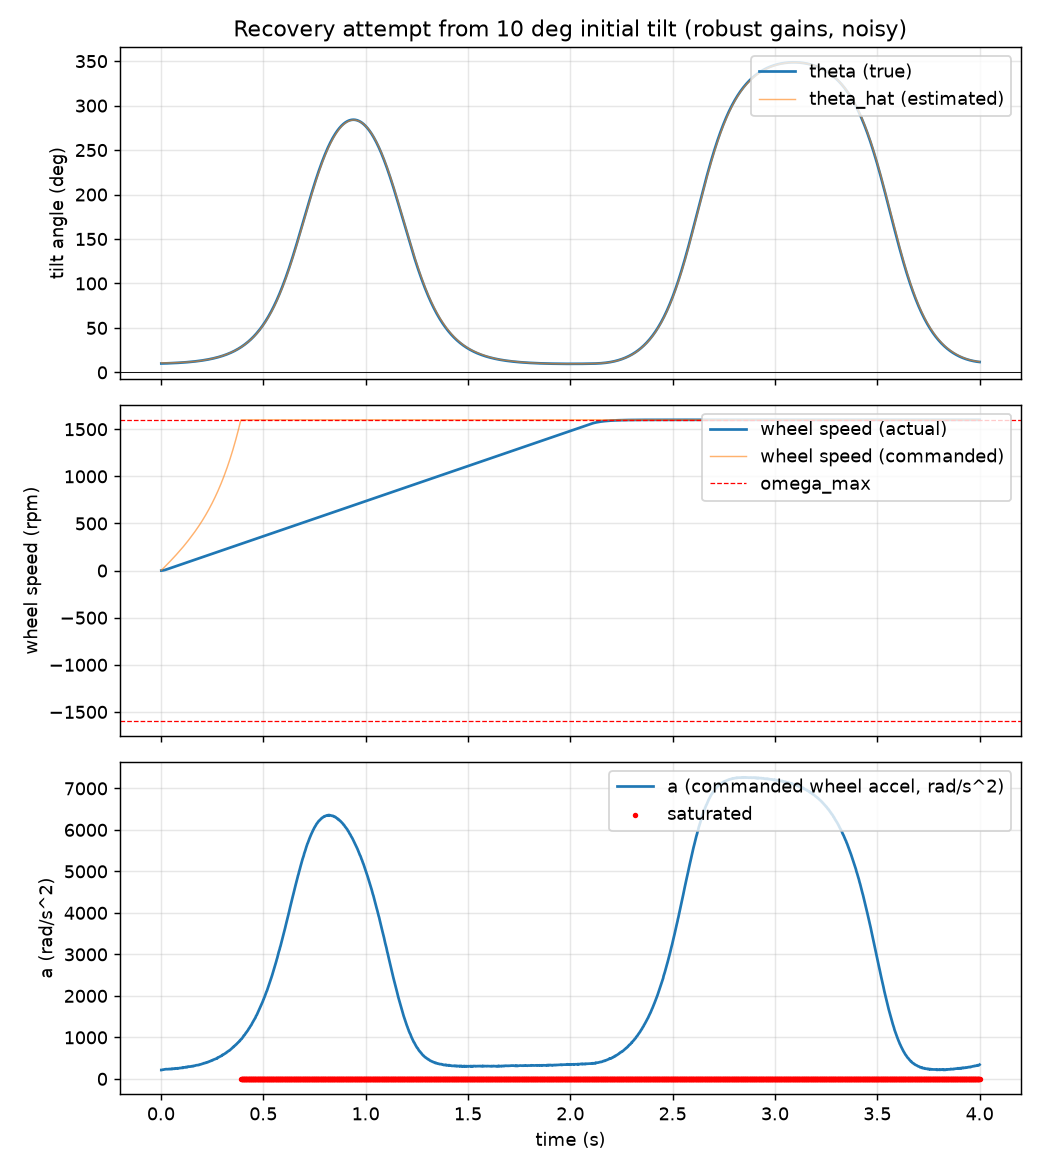
sim/out/recovery_10deg.png
