OAKHEN1412/reaction-wheel-balance/tuning/motor_fg.md

# ผลวัดมอเตอร์ BLDC-3640 และสัญญาณ FG

## Step response (`firmware/step_test`, 12V, โครงยึดนิ่ง)

วัด 2 รอบได้ผลเท่ากัน · log: `logs/step_test.log.gz`

| duty | ความเร็วล้อคงที่ | t63 (ล้อเปล่า) | t63 (มีน็อตถ่วงที่ขอบล้อ) |
|---|---|---|---|
| 0.29 | 153–156 rpm | 0.155 s | 0.45 s |
| 0.49 | 279–291 rpm | 0.175 s | 0.53 s |
| 0.68 | 390–425 rpm | 0.215 s | 0.59 s |

**ข้อสรุป:** ความเร็วคงที่แปรตาม duty แต่ t63 แปรตามความเฉื่อยล้อ → ไดรเวอร์เป็นแบบ **จ่ายแรงดัน (voltage mode)**
ไม่ใช่ลูปควบคุมความเร็วที่มี soft-start → เฟิร์มแวร์จึงสั่งเป็นแรงบิดด้วย `duty = (ω + τ·a)/ω_fs`

- ที่ duty เต็ม ความเร็วล้อประมาณ 585 rpm (มอเตอร์ ~3500 rpm ที่อัตราทด 6)
- **การเพิ่มน้ำหนักที่ล้อทำให้แย่ลง** (t63 เพิ่ม 3 เท่า แรงบิดเท่าเดิม) → ถอดน็อตออกแล้ว
- ตอนออกแรงต่อเนื่องขณะทรงตัว ล้อเร่งได้จริงประมาณ **40 rad/s²** เทียบกับโมเดลที่คาด ~110 → น่าจะติดขีดจำกัดกระแส
  (สเปคแหล่งจ่ายไฟยังไม่ทราบ ถ้าต่ำกว่า 3A ควรลองเปลี่ยน)

## สัญญาณ FG

- FG ส่งพัลส์**เฉพาะตอนไดรเวอร์กำลังขับ** หมุนล้อด้วยมือไม่มีพัลส์ → วัด coast ไม่ได้
- ประมาณ 70 พัลส์ต่อรอบล้อ (น่าจะเป็น 12 ต่อรอบมอเตอร์ = 72 ต่อรอบล้อ)

### ห้ามใส่ R pull-up ภายนอก ❌ (ทดสอบ A/B 2026-09-20, log: `logs/fg_diag.log.gz`)

| duty | ใส่ R 4.7k ไป 5V | ไม่มี R (ใช้ INPUT_PULLUP ของ Mega) | ที่ควรได้ |
|---|---|---|---|
| 300 | ~60 พัลส์/วินาที | **187** | ~180 |
| 600 | ~100 | **421** | ~390 |
| 900 | ~70 | **645** | ~600 |

### ปัญหา FG ที่เจอและวิธีรับมือในเฟิร์มแวร์

| อาการ | ที่เจอจริง | วิธีแก้ |
|---|---|---|
| พัลส์หลอกตอนกลับทิศ | อ่านได้ 30,000–42,000 rpm | ทิ้งพัลส์ที่ห่างกัน < `FG_MIN_PERIOD_US` (700 µs) |
| พัลส์หลอกใกล้เกณฑ์ | 782 rpm ตอนเริ่มเตะ | ไม่เช็คความเร็วเกินระหว่างขั้นเตะ |
| พัลส์หายตอนกระแสสูง | ค่าตกจาก -450 เหลือ -4 rpm | ถือว่าไม่ fresh ถ้าไม่มีพัลส์เกิน max(4×คาบ, 15 ms) |
| ค่ากระโดดไปมา | -436, -215, -429, -178, -21 rpm ใน 100 ms | ประมาณด้วยโมเดลแล้วปรับตาม FG แบบมี gate |

## ค่าอื่นที่วัดแล้ว

- อัตราทด **6.0** (ล้อ 1 รอบ = มอเตอร์ 6 รอบ, นับด้วยมือ)
- duty ต่ำสุดที่มอเตอร์เริ่มหมุน ≈ **0.10**
- ขั้ว: PWM กลับขั้ว, DIR LOW = CW (ยืนยันซ้ำ 2026-09-20: `dir 1` = ทวนเข็ม, `dir 0` = ตามเข็ม), BRAKE LOW = เบรก
- แกน IMU: θ = atan2(ay, az), อัตราจาก gyro X, เครื่องหมาย +1 ทั้งคู่, control sign +1

## ตรวจรับสายชุด Nano ก่อนบัดกรี (2026-09-21)

หลังย้าย PWM จาก D11 → D9 และ I2C ไป A4/A5 วัดซ้ำด้วย `firmware/motor_test` เทียบกับค่าเดิมตอนอยู่กับ Mega
(นับพัลส์ในหน้าต่าง ~5 วินาที หลังความเร็วนิ่งแล้ว)

| duty | dir 0 (ตามเข็ม) | dir 1 (ทวนเข็ม) | ค่าเดิมบน Mega (dir0 / dir1) |
|---|---|---|---|
| 300 | 191 พัลส์/วิ | 192 | 195 / 181 |
| 600 | 434 | 438 | 450 / 438 |
| 900 | 671 | 669 | 687 / 636 |

**ผ่านทั้งหมด** ต่างจากของเดิมไม่เกิน 3% ซึ่งอยู่ในความคลาดเคลื่อนการวัด

**สองทิศทางสมมาตรแล้ว** — เดิม dir0 แรงกว่า dir1 อยู่ ~7% ที่ duty 300 และ 900 ตอนนี้ต่างกันไม่ถึง 1%
เป็นไปได้ว่าสายชุดเดิมมีจุดสัมผัสไม่ดี **ข้อนี้อาจช่วยเรื่องการลุกฝั่ง +θ ที่เคยสำเร็จแค่ 2 ใน 4 ครั้ง**

เบรก: สั่ง `brake 0` ที่ duty 400 ล้อหยุดภายใน < 500 ms (2523 → 160 → 0 rpm) พัลส์ FG หยุดสนิท ปล่อยแล้วกลับมาหมุนปกติ

> สรุป: สายชุด Nano ใช้งานได้เทียบเท่าของเดิมทุกเส้น บัดกรีถาวรได้
