OAKHEN1412/reaction-wheel-balance/tuning/balance_gains.md

# การจูนเกนตอนทรงตัว (ฮาร์ดแวร์จริง)

เกนอื่นคงเดิมตลอด: **Kp 1137.4, Kw 1.0, Ki 0.0387, sign +1**, zero offset -0.276° (อยู่ใน EEPROM)
ทุกค่าวัดในโหมด voltage (`CONTROL_MODE_VOLTAGE = true`, `MOTOR_TAU_S = 0.18`)

## Kd sweep (2026-09-19)

เปลี่ยนค่าระหว่างที่โครงกำลังทรงตัวอยู่ แล้ววัดจาก log ช่วงละประมาณ 50–120 วินาที

| Kd | SD ของ θ | ช่วงของ θ | คาบการส่าย | duty กระตุก/20ms | log |
|---|---|---|---|---|---|
| 144.3 (LQR) | – | -16.9 ถึง +10.8 | 0.85 s | – | แกว่งแรงขึ้นจนล้มใน ~1.5 s |
| 220 | – | -19 ถึง +19 | 0.46–1.37 s | – | `logs/kd220.log.gz` ทรงได้ 1.4–9.7 s |
| 300 | 1.59° | -4.3 ถึง +3.7 | 0.46 s | – | `logs/kd300.log.gz` **ทรงได้เกิน 2 นาที** |
| 350 | 0.71° | -2.4 ถึง +1.9 | 0.35 s | 0.0159 | `logs/kd350.log.gz` |
| 400 | 0.49° | -2.5 ถึง +2.1 | 0.28 s | 0.0153 | `logs/kd400.log.gz` |
| **500** | **0.34°** | **-1.4 ถึง +0.8** | 0.20 s | 0.0189 | `logs/kd500.log.gz` ← ใช้ค่านี้ |

หยุดที่ 500 เพราะ SD ลดลงน้อยลงเรื่อย ๆ ส่วน duty เริ่มกระตุกมากขึ้น (ถ้าเพิ่มต่อจะเริ่มสั่น/มีเสียงหึ่ง)

## หลังเปลี่ยนวิธีประมาณความเร็วล้อ (2026-09-20)

`WheelSpeedEstimator` เปลี่ยนจาก "ใช้ค่า FG ตรง ๆ" เป็น "ใช้โมเดลแล้วปรับตาม FG แบบมี gate"

| เวอร์ชัน | SD ของ θ | θ เฉลี่ย | log |
|---|---|---|---|
| ใช้ FG ตรง ๆ (Kd 500) | 0.34° | -0.19° | `logs/kd500.log.gz` |
| **โมเดล + FG (Kd 500)** | **0.27°** | **-0.01°** | `logs/blend_balance.log.gz` |

## บทเรียนสำคัญ

- **เกนจาก LQR (Kd 144) ใช้กับของจริงไม่ได้** เพราะ sim สมมติมอเตอร์เร็วกว่าความจริงมาก ต้องเพิ่ม Kd ประมาณ 3.5 เท่า
- ปรับเกนระหว่างที่โครงทรงตัวอยู่ได้เลย ไม่ต้องแฟลชใหม่ ใช้ `kd <ค่า>` แล้ว `save` เมื่อพอใจ
- ค่าที่บันทึกใน EEPROM **ทับ** ค่า `DEFAULT_*` ใน `config.h` เสมอ

## Kw: 1.0 -> 3.0 (2026-09-21)

ตอนทรงตัวนาน ๆ ที่ Kw = 1 ความเร็วล้อไหลไปทางเดียวเรื่อย ๆ จนใกล้ชนเพดาน ทำให้ไม่เหลือแรงสำรองไว้กันล้ม

| Kw | ช่วงความเร็วล้อ | SD ของ θ |
|---|---|---|
| 1.0 | -178 ถึง -38 rpm (ไหลทางเดียว) | 0.27° |
| **3.0** | **55 ถึง 139 rpm (อยู่ในกรอบ)** | 0.31° |

แลกความส่ายเพิ่ม 0.04° กับการที่ล้อไม่วิ่งหนี — คุ้ม ตั้งเป็น `DEFAULT_KW` แล้ว

## ค่าสุดท้ายบน Mega ก่อนย้ายไป Nano (2026-09-21)

อ่านจาก EEPROM ด้วยคำสั่ง `get` ก่อนถอดบอร์ด:

```
kp=1137.4  kd=500.0  kw=3.0  ki=0.0387  sign=1  offset_deg=-0.276
```

**Nano เริ่มจาก EEPROM ว่าง** จึงใช้ค่า `DEFAULT_*` ใน `config.h` ซึ่งตรงกับข้างบนทุกตัวแล้ว
ยกเว้น **zero offset ที่ต้องตั้งใหม่ด้วยคำสั่ง `zero`** เพราะย้ายบอร์ดและยึด IMU ใหม่ มุมศูนย์ย่อมไม่เท่าเดิม

> ค่าชุดนี้จูนกับโครงตอนที่บอร์ดอยู่นอกตัวหุ่น พอรวมทุกอย่างขึ้นไปอยู่บนโครง มวลและจุดศูนย์ถ่วงเปลี่ยน
> **ต้องจูน Kd ใหม่** ค่าข้างบนเป็นแค่จุดตั้งต้น ไม่ใช่คำตอบ

## จูนใหม่บนชุด Nano (2026-09-22)

บอร์ดย้ายขึ้นไปอยู่บนโครงแล้ว มวลและจุดศูนย์ถ่วงเปลี่ยน จึงจูนใหม่ทั้งหมด
log: `logs/nano_kd_sweep.log.gz`

### ตั้งศูนย์ใหม่ก่อน — สำคัญที่สุดของรอบนี้

รอบแรกที่ลองทรงตัวด้วย offset เดิม (-1.986°) **ล้มทุกครั้ง** ทั้งที่เกนเท่าเดิม:

| | offset -1.986° (เดิม) | offset +0.399° (ใหม่) |
|---|---|---|
| มุมเฉลี่ย | +6.3° | **-0.00°** |
| ความเร็วล้อ | 660 rpm (ตัน) | **-88..2 rpm** |
| duty เต็มเพดาน | 95% ของเวลา | **0%** |

**บทเรียน:** มุมที่ค้างคงที่แม้แค่ 1–2° = แรงโน้มถ่วงดึงคงที่ = ล้อต้องเร่งไม่หยุดจนชนความเร็วสูงสุด
พอล้อตัน แรงบิดเหลือศูนย์ หมดสิทธิ์ต้าน **อาการนี้ไม่มีทางแก้ด้วยการปรับเกน ต้องตั้งศูนย์ให้ตรง**
ทุกครั้งที่ขยับของบนโครง ต้อง `zero` ใหม่เสมอ

### Kd sweep (ปรับสดระหว่างทรงตัว ช่วงละ ~40 วินาที)

| Kd | SD ของ θ | ช่วงของ θ | ความเร็วล้อ | duty สูงสุด |
|---|---|---|---|---|
| 400 | 0.55° | -2.2 ถึง +2.0 | -84..-20 | 0.22 |
| **450** | **0.42° / 0.51°** (วัด 2 รอบ) | -1.3 ถึง +1.8 | -70..-28 | 0.19 |
| 500 | 0.45° | -1.8 ถึง +1.9 | -88..2 | 0.21 |
| 600 | 3.32° | -11.7 ถึง +11.1 | -663..-18 | **1.00 ตัน** |

**ค่า 400–500 ให้ผลพอ ๆ กันหมด** วัด 450 สองรอบได้ 0.42 กับ 0.51 ซึ่งคร่อมค่าของ 400 และ 500 อยู่

### ⚠️ ตารางข้างบนวัดสั้นเกินไป เชื่อไม่ได้

วัดซ้ำที่ **63 วินาที** (ของเดิม 38–43 วินาที) ผลต่างหายไปหมด:

| Kd | SD วัด ~40 วิ | **SD วัด 63 วิ** | ช่วงของ θ | duty สูงสุด |
|---|---|---|---|---|
| 450 | 0.42 / 0.51 | **0.370** | -1.3 ถึง +1.7 | 0.24 |
| 500 | 0.45 | **0.357** | -1.1 ถึง +1.7 | 0.25 |

ต่างกัน 0.013° = ไม่มีนัยสำคัญ **สองค่านี้เท่ากัน** ตัวเลขที่กระจาย 0.42–0.55 ตอนวัด 40 วินาที
คือความผันผวนของกลุ่มตัวอย่างเล็ก ไม่ใช่ความต่างจริงของเกน

**บทเรียนวิธีวัด: ต้องเก็บอย่างน้อย 60 วินาทีต่อค่า** ไม่งั้นจะหลงเลือกค่าตามสัญญาณรบกวน

**เลือก 450** เพราะเมื่อผลเท่ากัน ควรเอาค่าที่ห่างจากขอบที่ 600 มากกว่า
เผื่อ margin ตอนมวลเปลี่ยนหรือแรงดันแบตตก และตอนลุกขึ้นเองซึ่งสภาวะรุนแรงกว่าการทรงตัวเฉย ๆ

ที่ 600 ระบบแกว่งจนล้อวิ่ง -663 rpm และ duty ชนเพดาน — เส้นแบ่งอยู่ระหว่าง 500 กับ 600 ชัดเจน

### เทียบกับชุด Mega เดิม

- ชุดเดิมยิ่งเพิ่ม Kd ยิ่งดี (500 ดีที่สุด SD 0.34) **ชุดใหม่กลับกัน เกิน 500 แล้วพัง**
- แต่ชุดใหม่ **มีกำลังสำรองเยอะกว่ามาก**: duty สูงสุดแค่ 0.19–0.22 (เดิมกระตุกบ่อยกว่านี้)
- ความส่ายแย่กว่าเดิมเล็กน้อย (0.42 เทียบ 0.34) ซึ่งสมเหตุสมผลเพราะมวลบนโครงเพิ่มขึ้น

### ค่าที่ใช้ตอนนี้ (บันทึกลง EEPROM และเป็นค่าเริ่มต้นใน config.h แล้ว)

```
kp=1137.4  kd=450  kw=3.0  ki=0.0387  sign=1  offset_deg=+0.399
```
