OAKHEN1412/reaction-wheel-balance/tuning/jump_runs.csv

date | spin_rpm | kick_ms | capture_deg | energy_k | firmware_note | spinup_ms | peak_rate_dps | capture_deg_actual | capture_rate_dps | overshoot_deg | settle_ms | result | note
2026-09-20 | 100 | 20 | 10 |  | angle handover |  | 10 |  |  |  |  | abort_kick_expired | ยกขึ้นได้ 1.7 องศา (ค่าปลอดภัยรอบแรก)
2026-09-20 | 100 | 100 | 10 |  | angle handover |  |  |  |  |  |  | abort_spin_guard | ตัวป้องกัน 10 dps ตอนหมุนล้อเข้มเกินไป -> ผ่อนเป็น 4 องศา/40 dps
2026-09-20 | 100 | 100 | 10 |  | guards loosened | 60 |  |  |  |  |  | abort_kick_expired | ยกถึง ~-6 องศา แต่เบรกตอน abort ดึงกลับ
2026-09-20 | 100 | 200 | 10 |  | accel gating |  |  | -9.5 | -12 |  |  | fell | ส่งต่อตอนกำลังตกกลับ ล้อชนเพดานความเร็ว
2026-09-20 | 200 | 350 | 10 |  |  |  |  |  |  |  |  | abort_fg_overspeed | FG พัลส์หลอก 782 rpm ตอนกลับทิศ -> เช็คเฉพาะช่วงหมุนล้อ
2026-09-20 | 200 | 350 | 10 |  | fg guard fixed |  |  | -9.5 | 31 |  |  | fell | ล้อเหลือความเร็วติดลบมาก ไม่มี headroom
2026-09-20 | 350 | 350 | 10 |  |  |  |  | -9.5 | 31 |  |  | fell | ยกถึง -3 องศา แล้วล้อชนเพดาน
2026-09-20 | 500 | 350 | 10 |  | spin duty scaled | 391 |  | -9.5 |  | 4.4 |  | balanced | **สำเร็จครั้งแรก** ทรงตัวต่อได้
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
