OAKHEN1412/reaction-wheel-balance/sim/out/capture_set/campaign_validation.csv

n | side | angle_deg | rate_toward_dps | wheel_rel_rpm | observed | predicted | sat_pct_1s | max_abs_angle_deg | max_opposite_deg | fail_reason
1 | - | 6.322 | 40.323 | -47.66 | False | False | 18.0 | 20.03419334071164 | 0.0 | 20deg
2 | + | 6.246 | 47.753 | -28.86 | False | False | 0.0 | 20.058524501574645 | 20.058524501574645 | 20deg
3 | - | 6.493 | 57.01 | -93.64 | True | False | 0.0 | 20.1264948188761 | 1.4402945302431236 | 20deg
4 | + | 6.106 | 36.853 | -72.43 | True | False | 28.8 | 20.095624127006314 | 0.0 | 20deg
5 | + | 7.621 | 52.395 | -39.13 | False | False | 0.0 | 20.066149490126488 | 0.0 | 20deg
6 | + | 6.776 | 40.685 | -19.36 | True | False | 32.6 | 20.078036969387586 | 0.0 | 20deg
7 | + | 5.708 | 47.021 | 31.35 | False | False | 1.4 | 20.026871668091914 | 0.0 | 20deg
8 | + | 7.333 | 44.547 | 23.13 | False | False | 32.2 | 20.068722407215255 | 0.0 | 20deg
