OAKHEN1412/reaction-wheel-balance/tuning/nano_2026-09-22_left_after_base_fix.csv

n | side | rest_deg | spinup_ms | peak_dps | cap_deg | cap_dps | cap_rpm | overshoot_deg | sat_pct | held_ms | result | note
1 | - | -17.7 | 495 | 68 | -6.5 | 46 | -267 | 17.7 | 0 | 1660 | FELL
2 | - | -17.4 | 471 | 69 | -6.9 | 61 | -131 | 19.9 | 0 | 3495 | held
3 | - | -17.7 | 439 | 69 | -7.3 | 59 | -116 | 17.3 | 0 | 2814 | FELL
4 | - | -15.0 | 435 | 66 | -5.5 | 56 | -170 | 6.8 | 0 | 3328 | held
5 | - | -17.7 | 436 | 70 | -7.2 | 53 | -77 | 1.0 | 27 | 1246 | FELL
6 | - | -17.7 | 436 | 68 | -5.3 | 28 | -176 | 17.7 | 0 | 2706 | FELL
7 | - | -17.7 | 433 | 64 | -6.8 | 50 | -91 | 3.1 | 33 | 1136 | FELL
8 | - | -17.6 | 411 | 70 | -7.5 | 52 | -75 | 0.2 | 24 | 1372 | FELL
9 | - | -17.4 | 436 | 58 | -7.7 | 57 | -307 | 7.7 | 20 | 4792 | held
10 | - | -17.7 | 245 | 54 | -7.4 | 53 | -350 | 6.8 | 0 | 3155 | held
11 | - | -17.7 | 434 | 59 | -7.7 | 40 | -52 | -2.4 | 30 | 974 | FELL
12 | - | -17.6 | 453 | 62 | -8.2 | 37 | -94 | -2.8 | 27 | 1048 | FELL
13 | - | -17.6 | 414 | 58 | -8.0 | 56 | -315 | 7.2 | 12 | 4570 | held
14 | - | -15.5 | 414 | 69 | -7.4 | 53 | -287 | 5.6 | 4 | 16985 | held
15 | - | -17.7 | 415 | 62 | -6.3 | 32 | 30 | -1.2 | 36 | 736 | FELL
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
