OAKHEN1412/reaction-wheel-balance/firmware/reaction_wheel_balance/config.h

#pragma once
#define PIN_IMU_INT      3   // optional (INT1); not currently used by the firmware logic
#if defined(__AVR_ATmega2560__)
#define PIN_MOTOR_PWM   11   // Timer1 OC1A on the Mega 2560
#else
#define PIN_MOTOR_PWM    9   // Timer1 OC1A on the ATmega328P (Nano/Uno)
#endif
#define PIN_MOTOR_DIR    7   // F/R direction level (white wire)
#define PIN_MOTOR_BRAKE  6   // brake level (green wire)
#define PIN_MOTOR_FG     2   // FG tach pulses (yellow wire), INT0, open-collector -> INPUT_PULLUP
#define CAPTURE_BLEND_MS    350UL
#define CAPTURE_KP_SCALE    0.25f
#define ENABLE_JUMP_BUTTON  1
#define PIN_JUMP_BUTTON     4
#define BUTTON_DEBOUNCE_MS 30UL
#if defined(__AVR_ATmega2560__)
#define ENABLE_SELFTEST 1
#else
#define ENABLE_SELFTEST 0
#endif
#define PWM_INVERT              true   // measured: raw pin HIGH = stopped
#define DIR_CW_LEVEL            LOW
#define BRAKE_ACTIVE_LEVEL      LOW
#define FG_PULSES_PER_WHEEL_REV  70.0f
#define FG_PULSES_PER_REV       (FG_PULSES_PER_WHEEL_REV / GEAR_RATIO)
#define FG_MIN_PERIOD_US         700UL
#define GEAR_RATIO               6.0f   // measured 2026-09-19: 1 wheel rev = 6 motor revs (hand count)
#define MOTOR_MAX_RPM            3500.0f
#define MOTOR_MIN_DUTY_FRACTION  0.10f  // measured: starts turning at duty ~100/1023
#define MOTOR_FULL_SCALE_WHEEL_RADPS ((MOTOR_MAX_RPM / GEAR_RATIO) * (2.0f * 3.14159265358979323846f / 60.0f))
#define PWM_FREQ_HZ              15625
#define PWM_RESOLUTION_BITS      10
#define PWM_MAX_DUTY             ((1 << PWM_RESOLUTION_BITS) - 1)
#define MOTOR_DEADBAND_FRACTION  (0.3f / MOTOR_FULL_SCALE_WHEEL_RADPS)
#define IMU_ACCEL_AXIS_NUM       1     // Y  (measured)
#define IMU_ACCEL_AXIS_DEN       2     // Z  (measured)
#define IMU_ACCEL_ANGLE_SIGN     1.0f  // +1 (measured)
#define IMU_GYRO_AXIS             0     // X  (measured)
#define IMU_GYRO_SIGN             1.0f  // +1 (measured)
#define ACCEL_GRAVITY_TOL_G       0.25f
#define GYRO_CAL_DURATION_MS      2000
#define IMU_FAIL_LIMIT             10
#define JUMP_IMU_FAIL_LIMIT         5
#define LOOP_RATE_HZ              500
#define LOOP_PERIOD_US            (1000000UL / LOOP_RATE_HZ)
#define TELEMETRY_RATE_HZ          50
#define UPRIGHT_HOLD_DEG           3.0f    // must be held within this many degrees...
#define UPRIGHT_HOLD_MS            500     // ...for this long, to leave WAIT_UPRIGHT
#define FALL_ANGLE_DEG             20.0f   // |theta| beyond this -> FALLEN
#define FALL_HOLD_DEG              12.0f   // |theta| beyond this...
#define FALL_HOLD_MS               300     // ...for this long also counts as FALLEN (rest stop is ~16 deg)
#define ENABLE_JUMP_UP             true
#define JUMP_SPIN_RPM              550.0f  // wheel RPM; command rejects values above 550.
#define JUMP_KICK_MS               450     // kick deadline; capture at JUMP_CAPTURE_DEG ends it (~190 ms at 500 rpm)
#define JUMP_CAPTURE_DEG           8.0f   // capture only during reverse-voltage KICK
#define JUMP_TARGET_RATE_DPS       75.0f
#define JUMP_COAST_HOLD_DUTY       0.20f
#define DEFAULT_KP                 1137.4f
#define DEFAULT_KD                 450.0f   // re-tuned 2026-09-22 on the Nano build (the board moved onto the frame,
#define DEFAULT_KW                 3.0f   // raised from 1.0 on 2026-09-21: at Kw=1 the wheel wound up
#define DEFAULT_KI                 0.0387f
#define DEFAULT_CONTROL_SIGN       1.0f   // MEASURED +1 (2026-09-19, firmware/sign_test): +omega spin-up kicks
#define MAX_WHEEL_SPEED_RADPS      (0.85f * MOTOR_FULL_SCALE_WHEEL_RADPS)
#define MAX_ACCEL_CMD_RADPS2       4000.0f // clamp on the raw acceleration/torque command 'a'
#define INTEGRAL_CLAMP             1.0f    // anti-windup clamp on the (optional) integral term
#define CONTROL_MODE_VOLTAGE       true
#define MOTOR_TAU_S                0.18f
#define ACTIVE_DECEL_BRAKE         false
#define DECEL_BRAKE_MARGIN_RADPS   20.0f   // |omega_est|-|omega_cmd| (same sign) needed to trigger a brake pulse
#define EEPROM_ADDR                 0
#define EEPROM_MAGIC                0x5242u   // "RB" -- bump if the stored layout changes
