OAKHEN1412/reaction-wheel-balance/(commit log)

2026-09-13 Initial Reaction Wheel Balance project: wiring, ESP32-C3 firmware, sim, docs
    Circuit docs and schematic, balance firmware with IMU/motor bring-up sketches,
    Python LQR gain design and hardware-requirement sweep, overview page, handoff.
    Claude-Session: https://claude.ai/code/session_013RV8QWDqFjuHkHBVx921Ua
    [hardware_requirements.csv]
2026-09-19 First successful balance: Mega port, voltage-mode control, FG filter
    - Switch controller to Arduino Mega 2560 (5V logic drives the BLDC-3640
    DIR/BRAKE pull-ups directly); keep ESP32 sketches in firmware/legacy_esp32
    - Measured on hardware: motor polarity, IMU axes (atan2(ay,az), gyro X),
    gear ratio 6, control sign +1 (sign_test), open-loop step response
    (step_test: voltage-mode driver, tau ~0.18 s with bare wheel)
    - Voltage/torque command: duty = (omega_w + tau*a)/omega_fs instead of an
    integrated speed setpoint (sim 0/20 -> 20/20 at tau 0.18)
    - Reject FG glitch edges (<700 us) that read as 30k+ rpm around DIR flips
    - Hardware-tuned Kd 500: balanced for minutes, tilt SD 0.34 deg
    - Ad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
    [balance_controller.h, complementary_filter.h, config.h, design_gains.py, fg_tach.cpp, imu.cpp, imu_test.ino, model.py]
2026-09-19 Self-righting jump, web control panel, robust wheel-speed estimate
    - Jump-up from the +/-16 deg rest stop: voltage-mode spin-up then
    reverse-voltage kick, hand over to BALANCING below 10 deg
    (jump_controller.h, `jump [rpm] [kick_ms]`, `jumpcfg`, abort reasons).
    Hardware: 500/350 self-righted and kept balancing once; reaches ~0 deg
    most tries but usually falls after capture (suspected current limit)
    - sim/jumpup.py voltage-mode + plugging sweep; all results kept in
    sim/out/jumpup/ (CSV/JSON/plots + README)
    - tools/imu_viewer.html: Balance control tab (start/stop/jump/zero,
    gain editor, live charts, stats, CSV recording, serial console)
    - Wheel speed: model-based estimate corrected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
    [dropout_half_20ms.csv, dropout_half_50ms.csv, dropout_nominal.csv, expected_half_20ms_fg_dropout.csv, expected_half_20ms_ideal.csv, expected_half_50ms_fg_dropout.csv, expected_half_50ms_ideal.csv, expected_nominal_fg_dropout.csv]
2026-09-21 Rate-window jump handover (3/3 self-righting) + tuning records
    - Jump hands over on tilt RATE, not angle alone: kick until the frame rises
    faster than rate+15 dps, coast to bleed the excess, hand over below
    capture_deg while inside the rate band, kick again if it drops below.
    Hardware: 550/450/8deg/75dps balanced 3/3 (fixed-angle handover was 3/10)
    - The theoretical energy criterion sqrt(2K(1-cos theta)) did not survive
    hardware (overshot at 12 deg and again at 9.9 deg) -- the balance
    controller keeps adding energy after capture, so it is gone
    - `jump [rpm] [kick_ms] [capture_deg] [rate_dps]`, defaults now 550/450/8/75
    - New tuning/ directory: jump_runs.csv (every run + why it fail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
    [jump_runs.csv]
2026-09-21 firmware: build for Arduino Nano as well as the Mega
    Moving the controller onto the frame as one unit means the ATmega328P,
    which the firmware did not fit on: 108% flash, 107% SRAM.
    The SRAM overflow is almost entirely the `selftest` command -- its
    failure messages are plain literals, so ~1.1 kB of them sit in .data.
    The tests are pure logic with no board dependency, so ENABLE_SELFTEST
    compiles them out on anything that is not a Mega. Run `selftest` on the
    Mega before flashing the Nano. Nano now builds at 82% flash / 53% SRAM.
    Timer1 OC1A, which motor.cpp drives directly for 15.6 kHz PWM, is D11 on
    the Mega and D9 on the 328P, so PIN_MOTOR_PWM follows the chip. I2C moves
    to A4/A5 but Wire.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
    [config.h, imu.cpp, motor.cpp, reaction_wheel_balance.ino]
2026-09-21 motor_test: follow the chip for the Timer1 PWM pin, and verify the Nano wiring
    Same OC1A pin split as the main firmware (D11 on the Mega, D9 on the 328P).
    Bring-up measurements on the rewired Nano, against the Mega baseline:
    FG pulse rate is within 3% at duty 300/600/900 in both directions, the
    brake stops the wheel in under 500 ms, and I2C finds the IMU on A4/A5.
    The two directions are now symmetric (<1% apart) where the old harness
    had dir0 running ~7% faster than dir1. That asymmetry is a candidate
    explanation for the +theta self-righting side only succeeding 2 of 4
    times, so it is worth re-testing both sides after the rebuild.
2026-09-21 firmware: physical jump/stop button on D4
    A momentary switch to GND on D4, read as a debounced falling edge with
    the internal pull-up. It needs no new logic for the two rest positions:
    JumpController::begin() already picks the kick direction from the sign of
    the current tilt, so one button launches from either side.
    The button and the `jump` command now go through one startJump(), rather
    than each carrying its own copy of the safety conditions, which is how
    they would have drifted apart. `stop` likewise moved into stopMotion().
    The button also stops a running machine. That is worth more than it looks
    once the robot is self-contained on 12V: with the USB cable off there is
    otherwise no way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
    [config.h, reaction_wheel_balance.ino]
2026-09-21 imu: probe both MPU-6050 addresses instead of assuming 0x68
    AD0 selects the address and the wiring ties it to GND for 0x68, but a
    missing or broken AD0 wire leaves the pin floating, and then the part
    answers on 0x68 or 0x69 and can change between resets. That cost a long
    bring-up session: the module was alive and healthy, the firmware simply
    was not talking to the address it had landed on.
    begin() now takes whichever of the two answers, preferring the wired-for
    0x68, and prints a warning when it ends up on 0x69 so a floating AD0 is
    reported rather than silently tolerated.
    [imu.cpp]
2026-09-21 tune: re-tune the balance gains for the on-frame Nano build
    Moving the board onto the frame changed the mass and the centre of
    gravity, so the old gains no longer applied.
    The zero offset mattered far more than any gain. With the old offset
    (-1.986 deg) the machine failed every attempt: it sat at +6.3 deg mean
    tilt with the wheel pinned at 660 rpm and duty saturated 95% of the time.
    A steady tilt is a steady gravity torque, and a reaction wheel can only
    answer that by accelerating forever, so it runs out of wheel and then has
    no authority at all. Re-zeroing to +0.399 deg gives mean tilt -0.00 deg,
    wheel bounded at -88..2 rpm and duty never above 0.22.
    Kd sweep at the new zero: 400 -> SD 0.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
    [config.h]
2026-09-21 tune: re-measure Kd 450 vs 500 over 60s -- the difference was sampling noise
    The first sweep used 38-43 s per setting and reported 0.42-0.55 deg of
    tilt SD, which looked like a real ordering. Matched 63 s runs give 0.370
    for Kd 450 and 0.357 for Kd 500: the same value. The earlier spread was
    short-sample variance, so the claim that 450 measurably beat its
    neighbours does not hold.
    Keeping 450 anyway, now for the stated reason rather than a measured one:
    when two settings perform the same, take the one further from the 600
    cliff where duty saturates.
2026-09-21 jump: catch blend and a coast ordering fix; self-righting still only 38%
    About 90 launches today. The best configuration lands 3 in 8. Two changes
    survived, both for reasons rather than for a number:
    - Capture blend: Kp against the 8 deg the jump hands over asks for about
    160 rad/s^2 from a motor that delivers 40, so the wheel saturated
    immediately and the constant maximum torque threw the frame past
    upright. The angle gain now fades in over 350 ms from 25% while the
    rate gain stays full, so the catch spends that window killing rotation.
    - COAST now tests the tilt rate before the angle. Testing the angle first
    handed over frames that had coasted to 13-34 dps, which fell every
    ti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
    [jump_runs.csv]
2026-09-22 docs: rewrite the README for a public audience
    The README still described the state before any hardware existed -- Mega
    2560, jump-up "impossible", "not yet tested on real hardware" -- while the
    machine has balanced for over two minutes and rights itself about 38% of
    the time. It now leads with the measured numbers and says plainly that the
    remaining limit is actuator authority, not tuning.
    Also removes local Windows paths and a private artifact link from
    HANDOFF.md, since the repo is about to become public.
2026-09-22 tuning: per-session serial bridge and a whole-log jump summariser
    Both tools lived in a session scratchpad and were lost with it. They belong
    in the repo: every tuning session needs them.
    jumpruns.py walks a whole log instead of one launch at a time, and counts a
    catch that stood for 3 s as a success even if it drifted over a minute
    later -- what the jump has to deliver is a frame the balance loop can take
    over. On the 2026-09-22 campaign log it reproduces the recorded 3/8, and
    prints the one column that separated them: duty saturation in the first
    second after handover, 0% across all three successes against 24% average
    across the five failures.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
2026-09-22 jump: stop aborting the spin-up on a single FG glitch
    Two launches in a batch of six were thrown away today by the overspeed
    guard reading 719 and 806 rpm off a frame sitting still with a stopped
    wheel. FG_MIN_PERIOD_US only rejects glitches above ~1220 rpm, so ones in
    this range reach the guard. It now wants three consecutive readings; a
    real overspeed persists for far longer than the 6 ms that costs, and a
    glitch pulse does not.
    The host test suite turned out to be red at HEAD, which is how a stale
    expectation about spin duty survived: it wanted full duty for a 100 rpm
    request, while spinDutyFor has scaled that to 0.6 since the jump work
    landed, and a second check expected an abort at 100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
    [nano_2026-09-22_left_side.csv]
2026-09-22 jump: keep the wheel alive through COAST
    Over 32 launches on a base that no longer slides, every catch that held
    arrived with the wheel still turning at 131-350 rpm, and every handover
    below 116 rpm fell. The ones that fell had coasted: gravity bleeds off the
    excess tilt rate, which is what COAST is for, but friction bleeds off the
    wheel at the same time -- and the wheel is the authority the balance
    controller needs a moment later. Duty saturation after the catch tells the
    same story from the other side: 5% across the seven that held, 25% across
    the sixteen that did not.
    COAST now holds the wheel instead of releasing it. A wheel at constant
    speed exerts no reaction torque, since torque foll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
    [config.h, jump_controller.h, reaction_wheel_balance.ino]
2026-09-22 session 2026-09-22/23: base slip was the hidden variable; serial link blocks tuning
    What held up:
    - Rubber/cleat under the base halved handover-rate variance (SD 21.5 -> 9.6
    dps) and removed the drift with elapsed time (r -0.79 -> -0.28; rest angle
    drift +0.56 -> +0.06). Every earlier A/B comparison was made on a machine
    whose base walked between launches.
    - All 7 catches that held on the fixed base arrived at 53-61 dps; 21 launches
    outside that window held none. Not in config.h yet -- derived from the
    data it would be tuned on, and this project has adopted such rules twice
    before and watched them collapse.
    - Spin-up strength is identical across the day (rpm at 300 ms: 449/448/44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
    [campaign_validation.csv, capture_grid.csv, gate2_g28.csv, gate2_g30_marginal.csv, gate2_g30_torque0.9.csv, launch_scan.csv, margin_grid.csv, margin_ranking.csv]
2026-09-22 firmware: flash and drive the Nano through a Mega 2560
    The Nano's onboard CH340 stopped accepting inbound bytes (board TX fine,
    upload 'not in sync', a 1 KB Blink fails the same way across five PC ports,
    two cables and with the driver unplugged). Two Mega sketches route around
    it: the stock ArduinoISP for flashing over SPI, and a Serial<->Serial1
    passthrough for the tuning bridge, with a '~RESET~' line that pulses the
    target reset since no DTR crosses the bridge. Wiring and commands are in
    firmware/README.md. Both compile for the Mega; ArduinoISP is loaded on the
    Mega (COM3) as of this commit.
    [mega_passthrough.ino]
2026-10-13 estimator: follow the wheel across zero instead of locking the old sign
    FG reports only |omega|; the sign comes from the first-order model
    (tau 0.18 s). On hardware the wheel reverses faster than that (a replay
    of logged duty matches a real tau of 0.05-0.08 s), so after a zero
    crossing the FG magnitude correction kept the model's old sign and drove
    the estimate to -110..-210 rpm while the wheel ran +100..+330. Voltage
    mode then subtracted that from the duty during recoveries; 12 of 14
    hand-push falls on 2026-10-13 showed this signature.
    While the applied command opposes the estimate the wheel can only slow
    down, so track the lowest FG magnitude; once FG climbs clearly above it
    (min*1.3 + 3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
2026-10-13 report: track the thesis build scripts; handoff for the report work
    report/_source builds the chapter 4, 5 and appendix Word files from the
    tuning logs (figs.py -> build4/5/appendix.py), composes the prototype
    photos, and draws the simulator-window figure from a real sim/ run.
    Chapter 3 cannot be rebuilt (its source pictures are gone), so
    ch3_rewrite.py records the current chapter 3 wording applied to the
    Word file directly.
    Only the scripts and report/README.md are tracked. The Word/PDF output
    carries names and personal details and this repo is public, so
    .gitignore keeps report/Word, PDF, รูป and _ต้นฉบับเก่า local.
    HANDOFF gains the 2026-10-13 report session: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
